Vlasevi/rtuindustrial/README.md

# rtuindustrial
It is a repository with the design files of Industrial RTU for a thesis degree.
