Vlasevi/rtuindustrial/Analog Inputs/Esquematico_capacitor.pdf

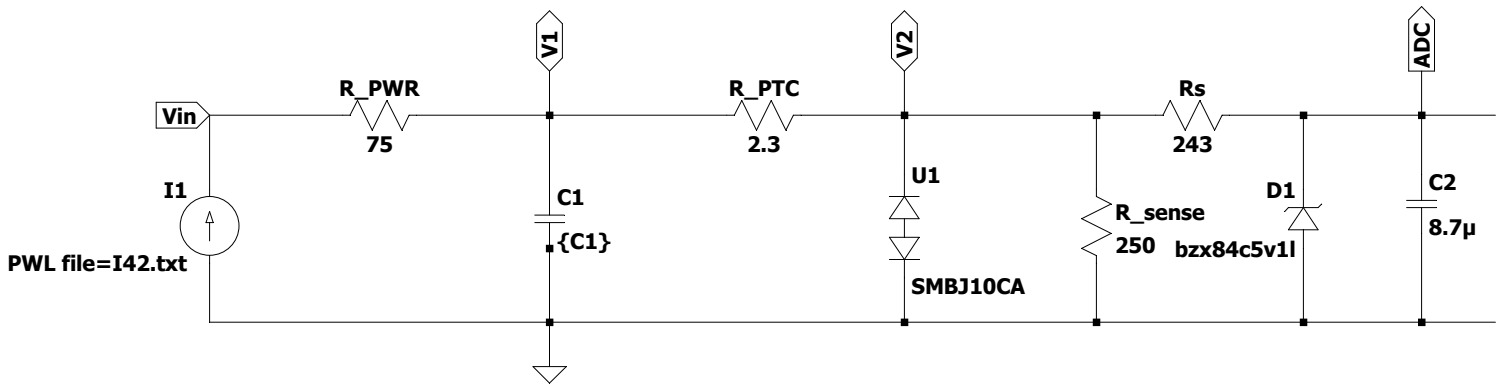
[picture p60: figure]
SMBJ10CA; bzx84c5v1l; R_PWR; R_PTC; R_sense 250; PWL file=I42.txt; ADC; Vin

.lib SPICE_SMBJxxxxCA.lib
.tran 500n
.lib bzx84c5v1l.lib
.step param C1 list 100p 1000p 10n

--- C:\Users\Vladimir Villamizar\Documents\Proyecto de grado\Analog Inputs\tvs_test1.asc ---
