Vlasevi/rtuindustrial/Analog Inputs/Esquemático.pdf

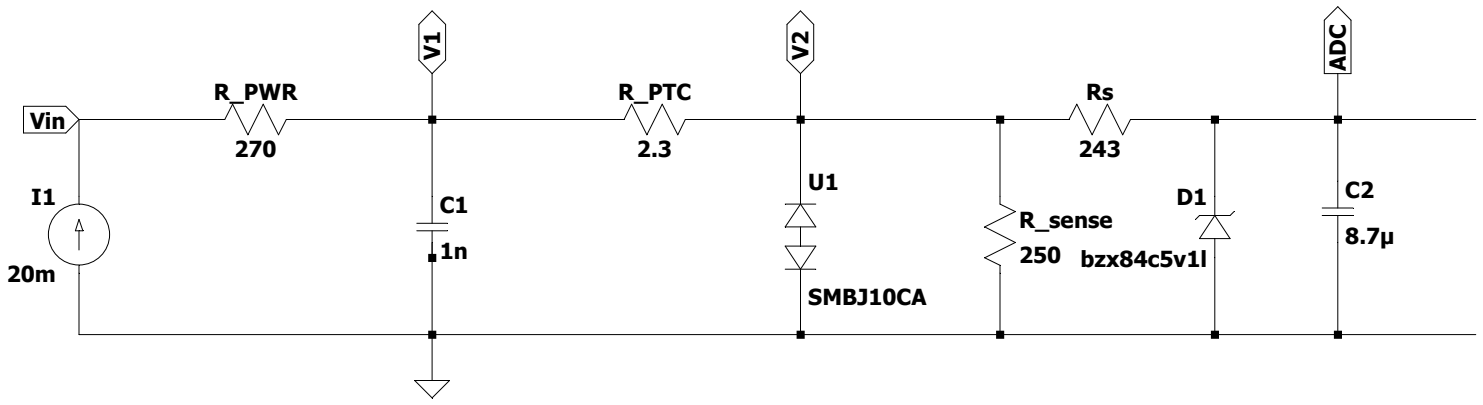
[picture p61: figure]
SMBJ10CA; bzx84c5v1l; R_PWR; R_PTC; R_sense 250; ADC; Vin

.lib SPICE_SMBJxxxxCA.lib
.dc I1 4m 20m 0.01u
.lib bzx84c5v1l.lib

--- C:\Users\Vladimir Villamizar\Documents\Proyecto de grado\Analog Inputs\tvs_test1.asc ---
