Vlasevi/rtuindustrial/Digital Output/Esquematico_figura.pdf

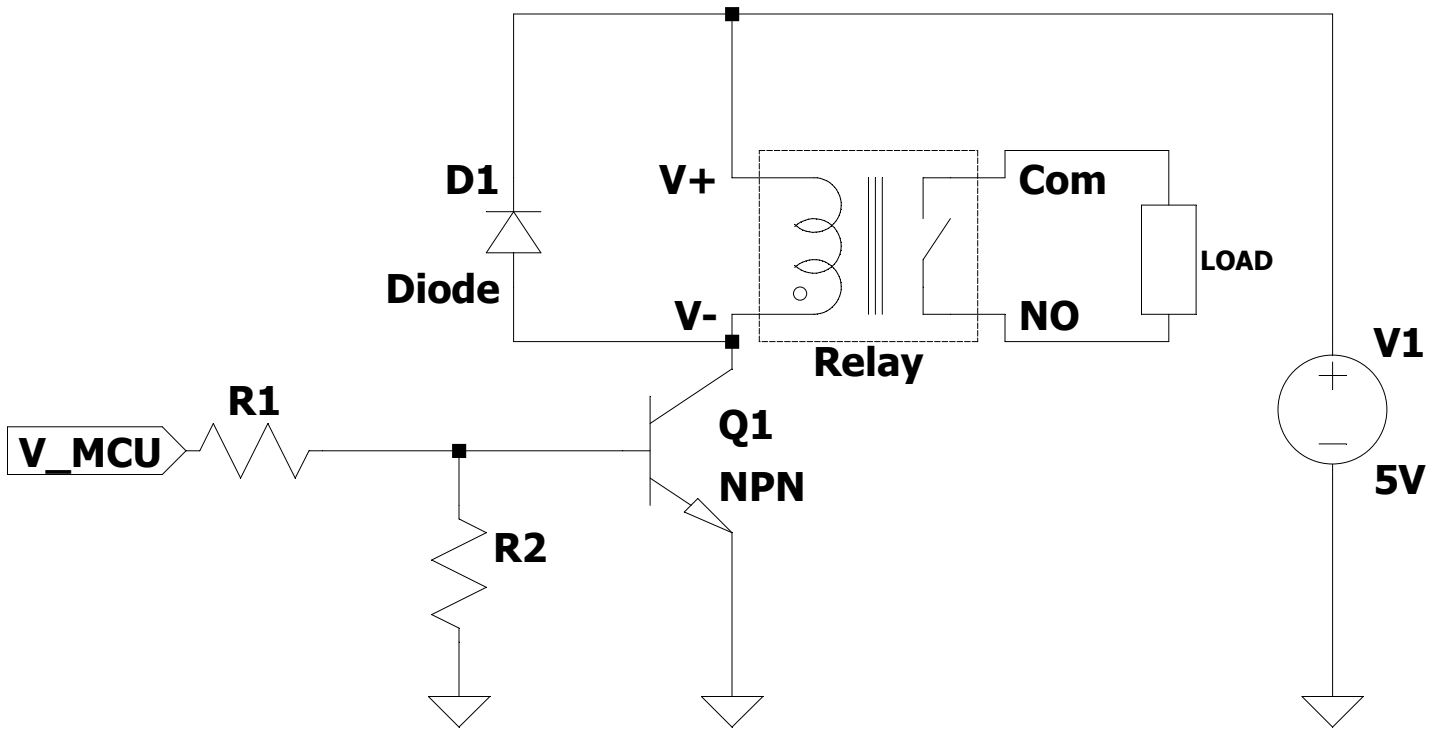
[picture p62: figure]
Q1 NPN; Relay; Com; Diode; V_MCU; LOAD

--- C:\Users\Vladimir Villamizar\Documents\Proyecto de grado\Digital Output\Esuquematico_figura.asc ---
