Vlasevi/rtuindustrial/Digital Output/Esquematico_simulacion.pdf

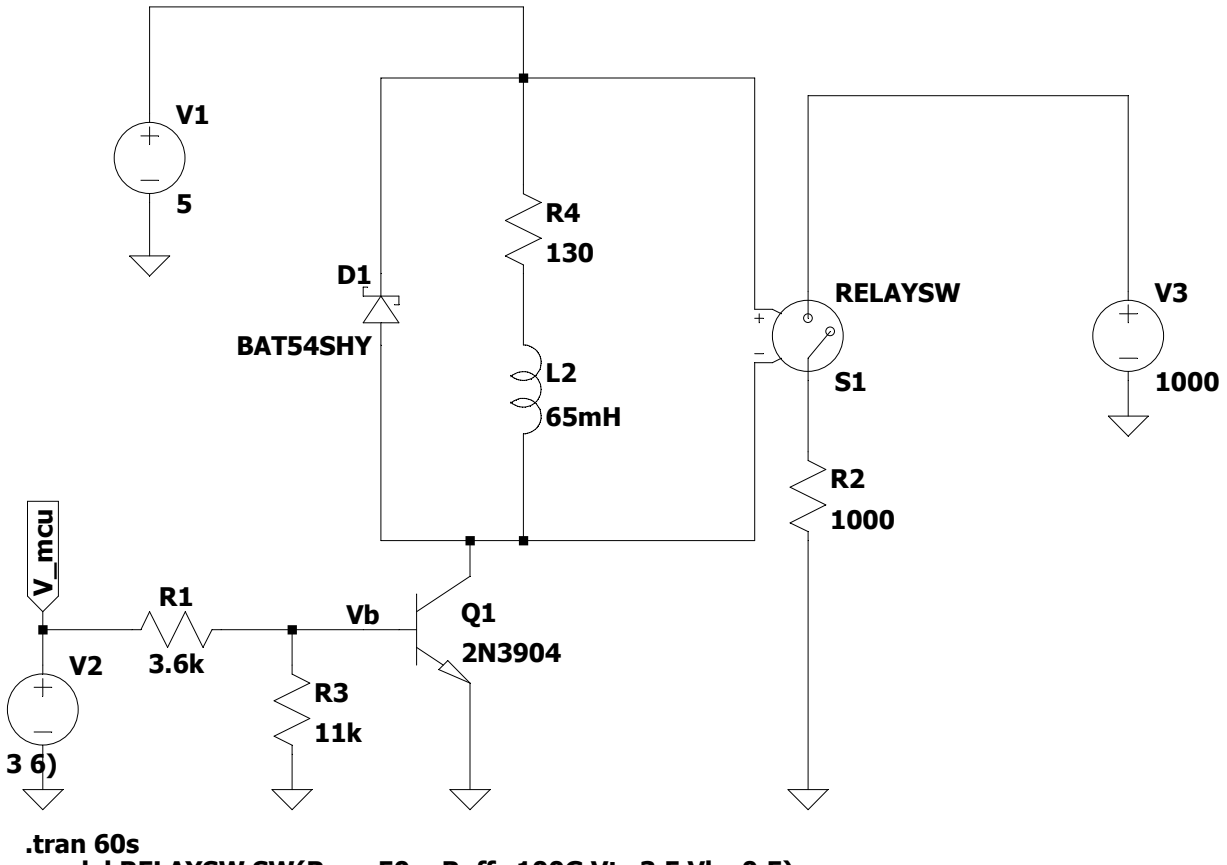
[picture p63: figure]
RELAYSW; BAT54SHY; Vb V_mcu; .tran 60s

PULSE(3.3 0 0 1n 1n 3 6)

.model RELAYSW SW(Ron=50m Roff=100G Vt=3.5 Vh=0.5)

--- C:\Users\Vladimir Villamizar\Documents\Proyecto de grado\Digital Output\DO.asc ---
