Vlasevi/rtuindustrial/Analog Inputs/Calculo rango para ADS114S08/ADS1x4S0x Design Calculator.xlsx

Sheet: Table of Contents
Worksheets | Description
Register Map | Lists the ADS1x4S0x register map fields, descriptions, and the corresponding read/write commands
Digital Filter | Calculates the digital filter's frequency response
Common-Mode Range | Calculates if an applied input signal will satisfy the absolute and differential input range requirements
Code Conversions | Converts ADC raw codes to corresponding voltages
Calibration | Calculations for offset and gain error calibration coefficients
CRC | Calculates the CRC byte
About | Information about this tool
Help | How to use this tool

Sheet: Register Map
 |  |  |  |  |  |  |  |  |  |  |  |  |  | Table of Contents
 | Show Register Map for: |  |  |  | ADS124S08 |  | ← Select a device
 |  |  |  |  |  |  |  | Configure register settings
 | Address (Hex) | Register Name | Read/Write | Default (Hex) | Bit # |  |  |  |  |  |  |  | Value | Read Command | Write Command
 |  |  |  |  | 7 | 6 | 5 | 4 | 3 | 2 | 1 | 0
0 | 0x00 | ID | R | 0xh | ---- |  |  |  |  | DEV_ID[2] | DEV_ID[1] | DEV_ID[0] | 00h | 20h, 00h, 00h | 40h, 00h, 00h
 |  |  |  |  | 0 | 0 | 0 | 0 | 0 | 0 | 0 | 0
 |  |  |  |  | Reserved |  |  |  |  | ADS124S08
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
