Vlasevi/rtuindustrial/Gerber Images PCB/+5.jpg

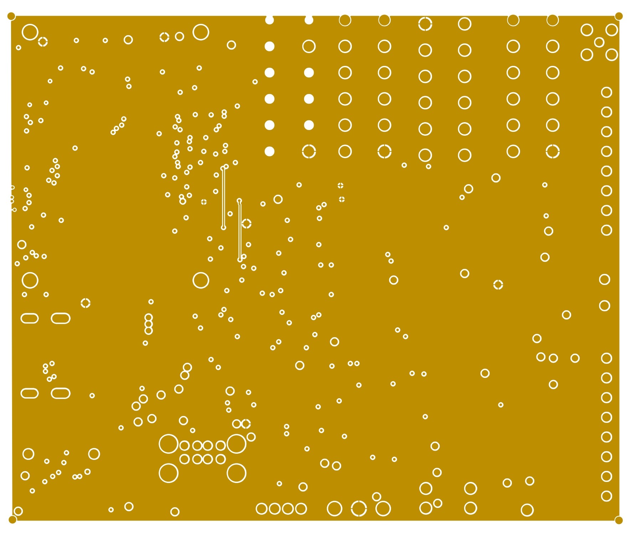
Gerber Images PCB/+5.jpg
