Vlasevi/rtuindustrial/Gerber Images PCB/Borde.jpg

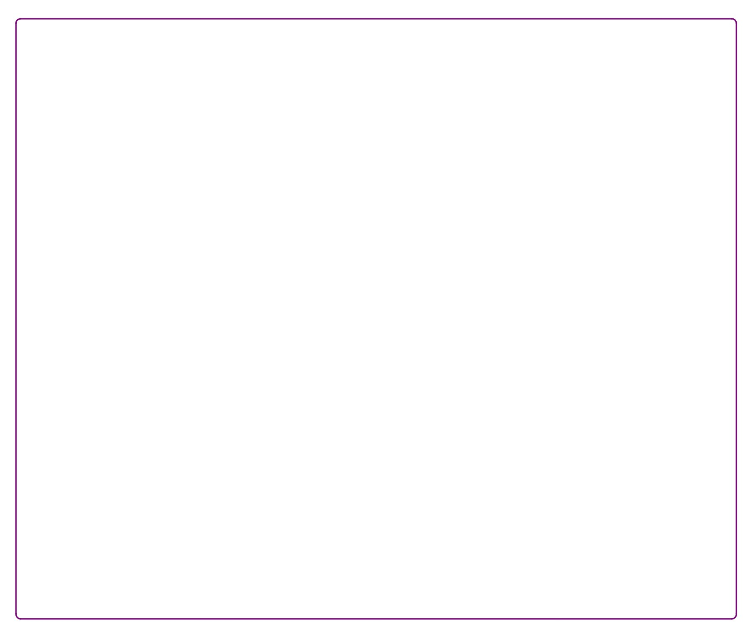
Gerber Images PCB/Borde.jpg
