Vlasevi/rtuindustrial/Gerber Images PCB/Bottom.jpg

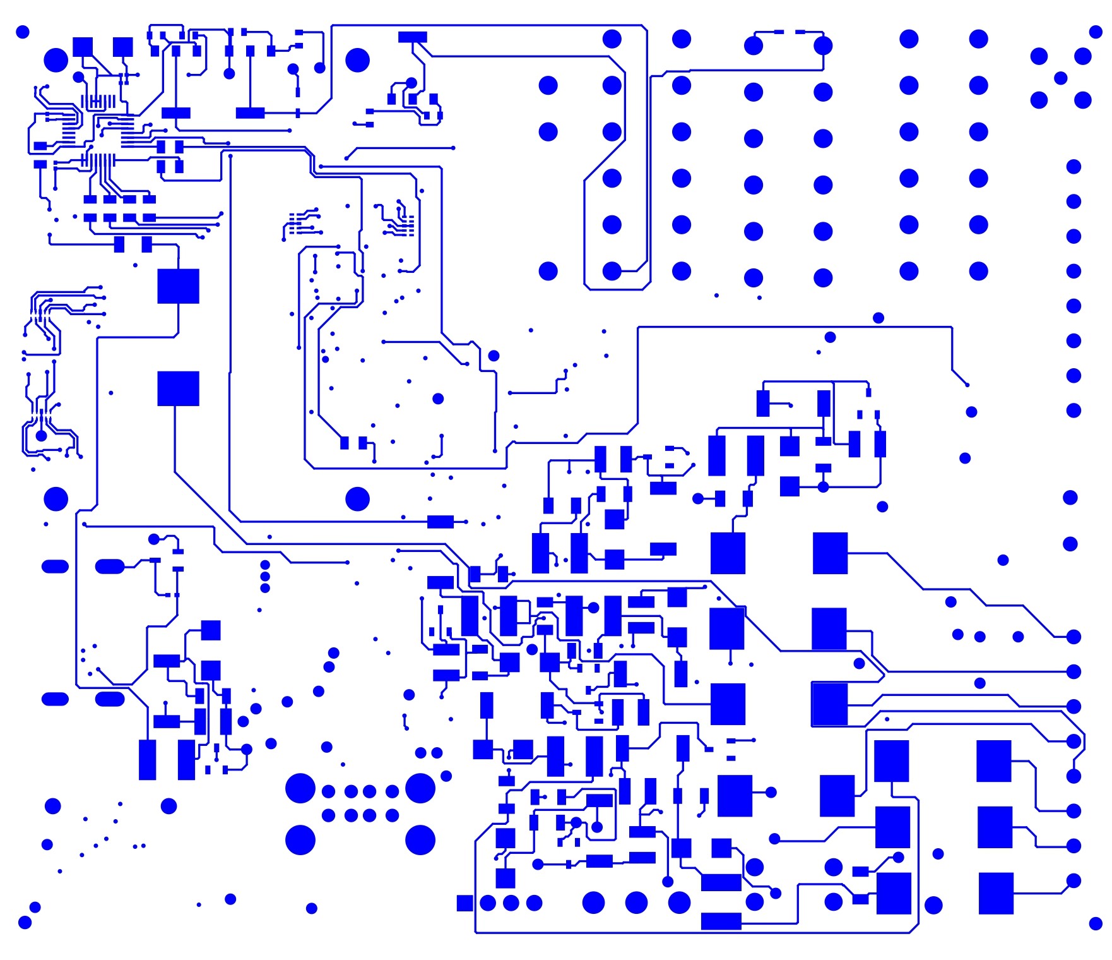
Gerber Images PCB/Bottom.jpg
