Vlasevi/rtuindustrial/Gerber Images PCB/GND.jpg

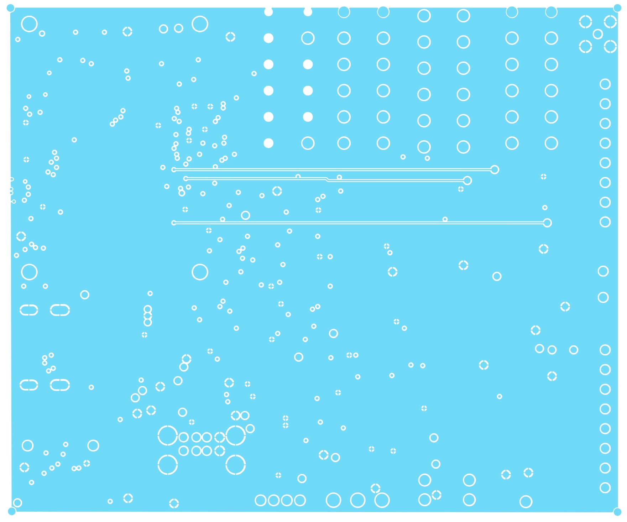
Gerber Images PCB/GND.jpg
