Vlasevi/rtuindustrial/Gerber Images PCB/Signal1.jpg

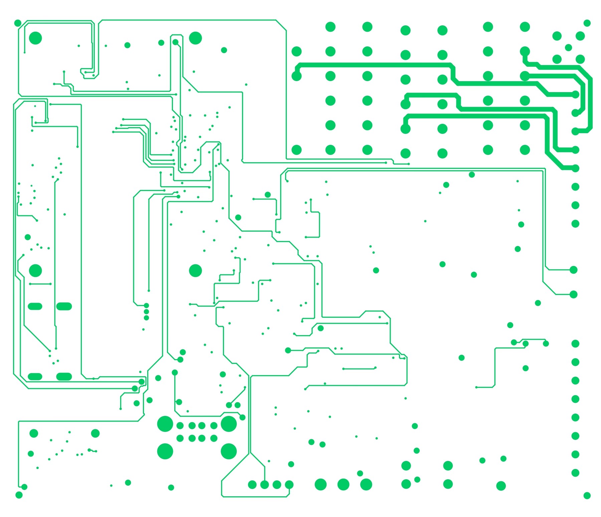
Gerber Images PCB/Signal1.jpg
