Vlasevi/rtuindustrial/Gerber Images PCB/Signal2.jpg

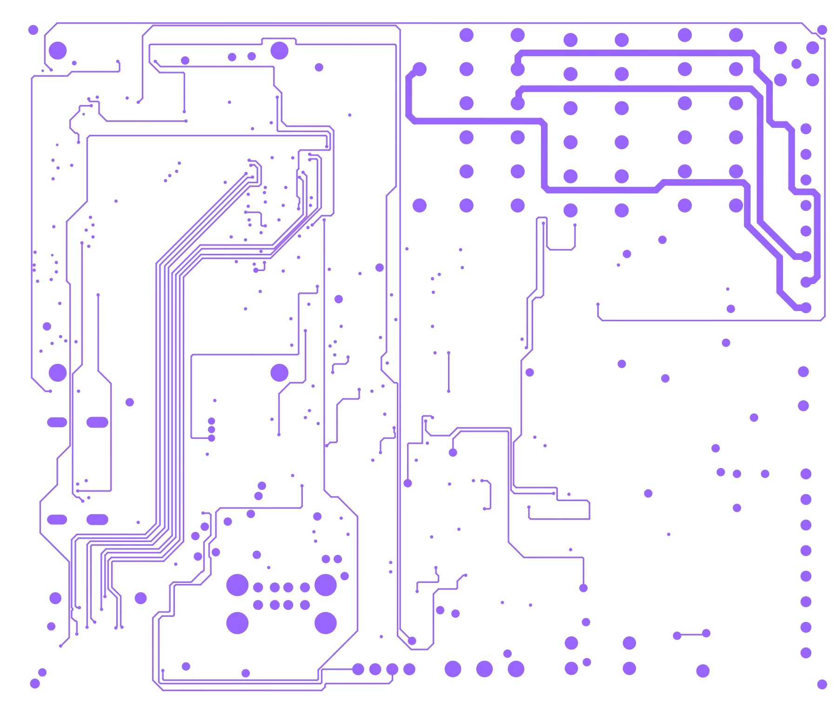
Gerber Images PCB/Signal2.jpg
