Vlasevi/rtuindustrial/Gerber Images PCB/Top.jpg

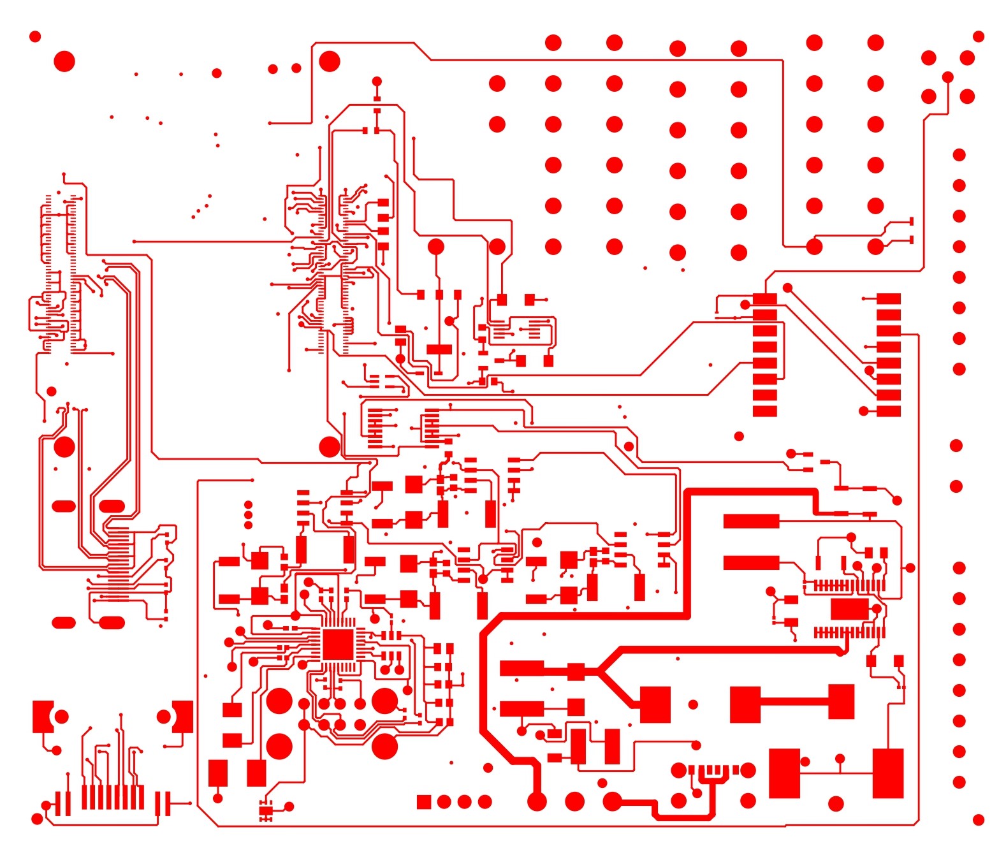
Gerber Images PCB/Top.jpg
