Vlasevi/rtuindustrial/Standards (Orcad and LTspice)/IEC 61000-4-4 (EFT)/IEC 61000-4-4.png

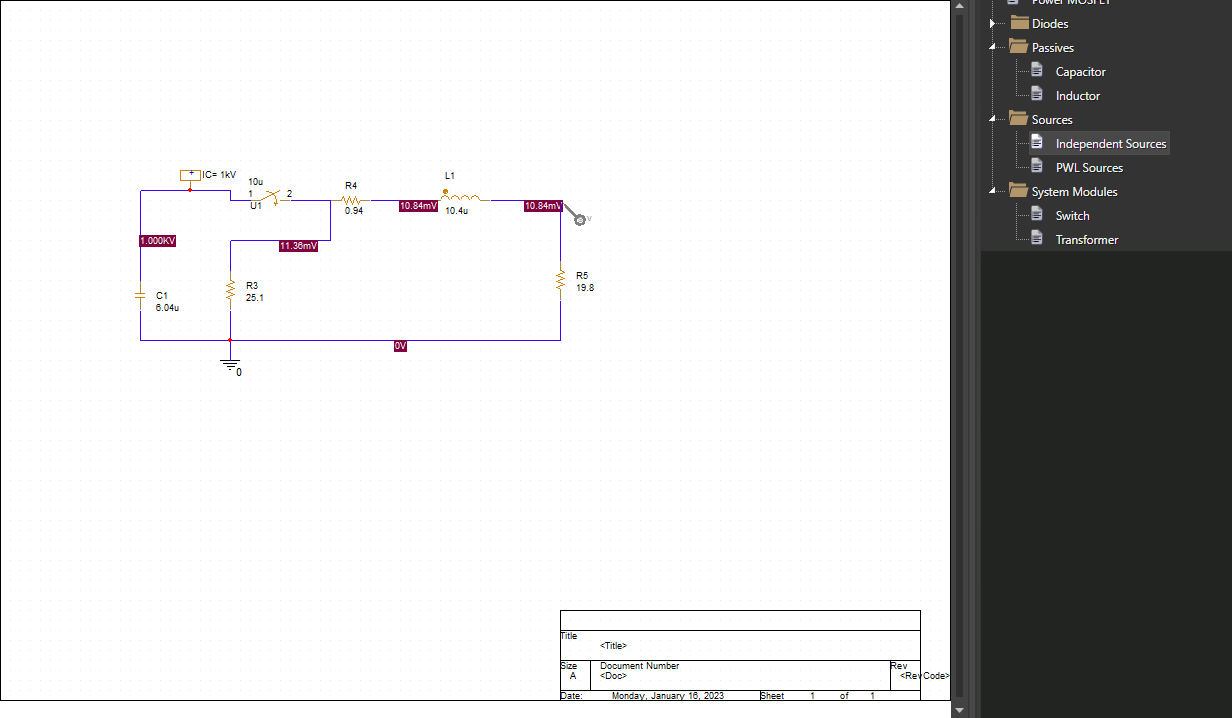
Standards (Orcad and LTspice)/IEC 61000-4-4 (EFT)/IEC 61000-4-4.png
