Vlasevi/rtuindustrial/Standards (Orcad and LTspice)/IEC 61000-4-5 (Surge)/IEC 61000-4-5.png

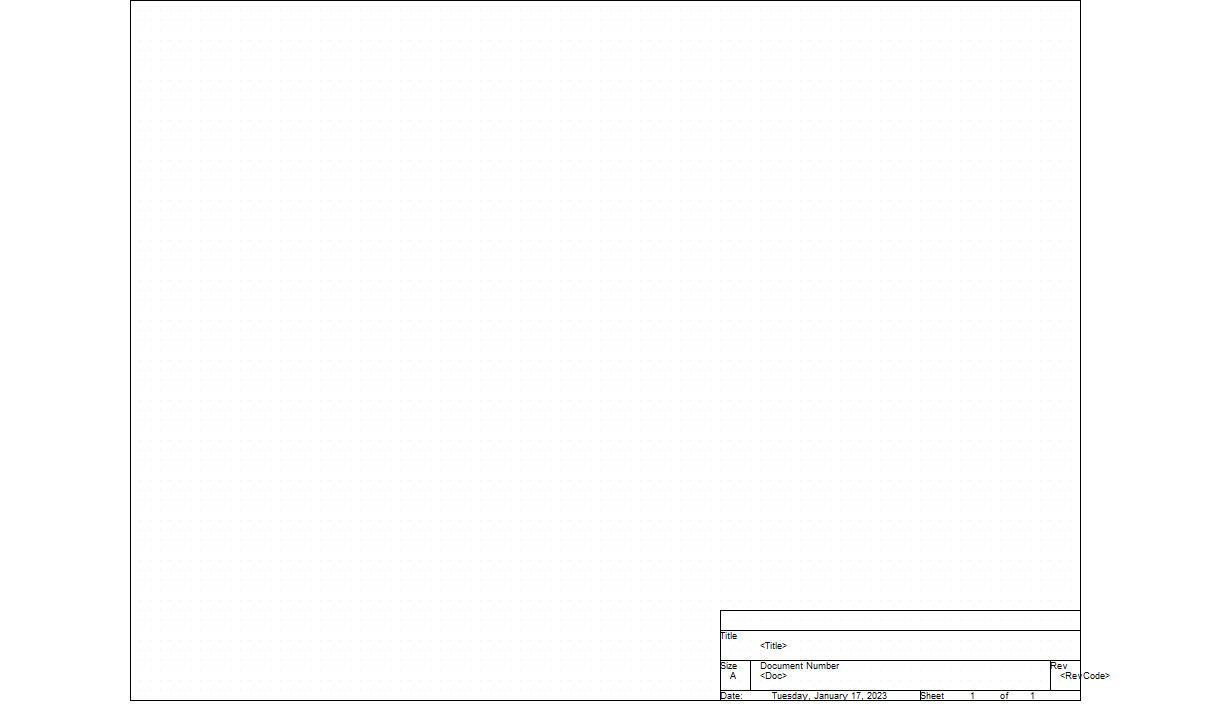
Standards (Orcad and LTspice)/IEC 61000-4-5 (Surge)/IEC 61000-4-5.png
