Vlasevi/rtuindustrial/Bill of Materials.xlsx

LISTA DE MATERIALES RTU INDUSTRIAL
Nombre | Tipo dispositivo | Nombre de parte | Cantidad | Fabricante | Distribuidor | Precio
1PS76SB10,115 | Schottky Diode | D16, D17, D18, D19 | 4.00 | Nexperia | Mouser | $0.27 | $1.08
0402YA270JAT2A | Capacitor | C40, C41 | 2.00 | KYOCERA AVX | Mouser | $0.10 | $0.20
445C33D24M00000 | Crystal or Oscillator | Y1(OSC) | 1.00 | CTS-Frequency Controls | Mouser | $0.52 | $0.52
1002-004-01010 | USB-A (USB TYPE-A), Stacked USB 2.0 | X1 | 1.00 | CNC Tech | DigiKey | $1.39 | $1.39
1101M2S3AV2BE2 | Switch | S3 | 1.00 | C&K | DigiKey | $5.16 | $5.16
2016L030 | Fuse | F1, F2, F3, F4, F5, F6, F7, F8 | 8.00 | LittleFuse | Mouser | $0.65 | $5.20
282834-4 | 4 Position Wire to Board Terminal Block Horizontal | J7 | 1.00 | TE Connectivity | Mouser | $2.37 | $2.37
282837-2 | Connector | J9 | 1.00 | TE Connectivity | Mouser | $0.68 | $0.68
352212KFT | Resistor | R67 | 1.00 | TE Connectivity | Mouser | $1.00 | $1.00
1727078 | Connector | J6, J8 | 2.00 | Phoenix Contact | Mouser | $5.60 | $11.20
6339191-5 | Conn RJ-45 F 8 POS | J1 | 1.00 | TE Connectivity | Mouser | $6.06 | $6.06
685119134923 | HDMI - Receptacle Connector 19 Position | J4 | 1.00 | Wurth Elektronik | Mouser | $2.52 | $2.52
885012207014 | Capacitor | C17 | 1.00 | Wurth Elektronik | Mouser | $0.10 | $0.10
ADS1148IPW | Integrated Circuit | IC1 | 1.00 | Texas Instruments | Mouser | $11.96 | $11.96
AP22653W6-7 | Integrated Circuit | IC14 | 1.00 | Diodes Incorporated | Mouser | $0.49 | $0.49
BZX84C5V1LT1G | Zener Diode | Z1, Z2, Z3, Z4, Z5,Z6,Z7,Z8 | 8.00 | Discret Semiconductor | Mouser | $0.16 | $1.28
C0201X5R6R3-105KNP | Capacitor | C19, C100 | 2.00 | Venkel | Mouser | $0.01 | $0.02
C0201X5R100-104KNP | Capacitor | C18, C29, C30 | 3.00 | Venkel | Mouser | $0.00208 | $0.01
C1206C102KAREC7210 | Capacitor | C1, C3, C5, C7, C9,C11,C13,C15 | 8.00 | KEMET | Mouser | $0.24 | $1.92
C1210X825K3RAC7800 | Capacitor | C2, C4, C6, C8, C10,C12,C14,C16 | 8.00 | KEMET | Mouser | $0.87 | $6.96
C3216X5R1A476M160AB | Capacitor | C34, C35, C36 | 3.00 | TDK | Mouser | $0.86 | $2.58
CC0603JPX7R9BB104 | Capacitor | C23, C24, C25, C26 | 4.00 | YAGEO | Mouser | $0.10 | $0.40
CDSOT23-SM712 | Diode | D21 | 1.00 | Bourns | Mouser | $1.53 | $1.53
CGA0603MLA-31900E | Varistor | RV1, RV2, RV3, RV4 | 4.00 | Bourns | Mouser | $0.40 | $1.60
CM21X5R107M06AT | Capacitor | C42 | 1.00 | KYOCERA AVX | Mouser | $1.27 | $1.27
CRCW20102K40JNEF | Resistor | RTHR1, RTHR2, RTHR3, RTHR4 | 4.00 | Vishay | DigiKey | $0.29 | $1.16
CRCW020115K0FKED | Resistor | R69 | 1.00 | Vishay | Mouser | $0.25 | $0.25
CRCW080547R0JNEAIF | Resistor | R33, R34, R35, R36,R37,R38,R39,R48 | 8.00 | Vishay | DigiKey | $0.55 | $4.40
CRCW0603010RJNEAHP | Resistor | R63, R64 | 2.00 | Vishay | DigiKey | $0.10 | $0.20
CRM1206QFX-1003ELF | Resistor | R59 | 1.00 | Bourns | Mouser | $1.22 | $1.22
CRT1206-PW-2500ELF | Resistor | R2, R6, R10, R14,R19,R23,R26,RR30 | 8.00 | Bourns | Mouser | $0.77 | $6.16
ERA-3ARB113V | Resistor | R50, R52, R54, R56 | 4.00 | Panasonic | Mouser | $0.68 | $2.72
ERA-3VEB3601V | Resistor | R49, R51, R53, R55 | 4.00 | Panasonic | Mouser | $0.65 | $2.60
ERA-8VRB1002V | Resistor | R60, R65, R66 | 3.00 | Panasonic | Mouser | $1.32 | $3.96
ERJ-1TNF2430U | Resistor | R4, R8, R12, R16,R20,R24,R28,R32 | 8.00 | Panasonic | DigiKey | $1.65 | $13.20
ESD224DQAR | Integrated Circuit | IC15c, IC16 | 2.00 | Texas Instruments | Mouser | $1.52 | $3.04
ESD321DPYR | TVS Diode (Bi-directional) | D29, D30, D31, D32 | 4.00 | Texas Instruments | Mouser | $0.37 | $1.48
ISO1211DR | Integrated Circuit | IC2, IC3, IC4, IC5 | 4.00 | Texas Instruments | Mouser | $1.07 | $4.28
KAM15CT70J106KT | Capacitor | C43, C44, C45, C46 | 4.00 | KYOCERA AVX | Mouser | $0.40 | $1.60
KRM55WR71J226MH01K | Capacitor | C33 | 1.00 | Murata | Mouser | $3.93 | $3.93
LTC3649EFE#PBF | Integrated Circuit | IC8 | 1.00 | Analog Devices | Mouser | $15.62 | $15.62
MAASL063SB7103KFCA01 | Capacitor | C37, C38 | 2.00 | 4D5156 TAIYO YUDEN | Mouser | $0.12 | $0.24
MCT0603HZ0000ZP500 | Resistor | RGND | 1.00 | Vishay | Mouser | $0.64 | $0.64
PJ-036AH-SMT-TR | DC Power Jack Connector | J5 | 1.00 | 4D5156 CUI Devices | Mouser | $1.40 | $1.40
PWR5322W1R00JE | Resistor | R57 | 1.00 | Bourns | Mouser | $1.16 | $1.16
PWR5322W5R00JE | Resistor | R1, R5 | 2.00 | Bourns | Mouser | $1.12 | $2.24
PWR5322W75R0JE | Resistor | R9, R13, R17, R21, R25, R29 | 6.00 | Bourns | Mouser | $1.42 | $8.52
PZT3904 | Transistor BJT NPN | Q1, Q2, Q3, Q4 | 4.00 | 333333 Micro Commercial Components | Mouser | $0.41 | $1.64
RC0402FR-0736KL | Resistor | R68, R70, R71, R72 | 4.00 | YAGEO | Mouser | $0.10 | $0.40
REF3033AIDBZRG4 | Integrated Circuit | IC19 | 1.00 | Texas Instruments | Mouser | $0.92 | $0.92
RFM95W-915S2 | RFM95(W) - Low Power | IC12 | 1.00 | RF Solutions | Mouser | $21.00 | $21.00
RMCF2512FT13R3 | Resistor | Rsense11, Rsense22,Rsense33,Rsense44 | 4.00 | Stackpole Electronics | DigiKey | $0.27 | $1.08
RN73C2A200KBTDF | Resistor | R58 | 1.00 | 4D5156 TE Connectivity | Mouser | $1.02 | $1.02
RT9742SNGV | Integrated Circuit | IC18 | 1.00 | 4D5156 Richtek USA | Mouser | $0.55 | $0.55
S2EB-5V | Relay or Contactor | K1, K2, K3, K4 | 4.00 | Panasonic | Mouser | $15.60 | $62.40
SC0320 | COMPUTE 4 1GB RAM 16GB EMMC | MCU | 1.00 | Raspberry Pi | MD | $44.00 | $44.00
SDR10EZPJ471 | Resistor | R61, R62 | 2.00 | ROHM | Mouser | $0.22 | $0.44
LPRS_SMA_CONNECTOR | Straight SMA Connector | J3 | 1.00 | LPRS | Mouser | $1.40 | $1.40
SMBJ10CA | TVS Diode (Bi-directional) | D1, D2, D3, D4,D5,D6,D7,D8 | 8.00 | LittleFuse | Mouser | $0.42 | $3.36
SMBJ30CA | TVS Diode (Bi-directional) | D10, D11,D12,D13,D14 | 5.00 | LittleFuse | Mouser | $0.37 | $1.85
SMBJ36CA | TVS Diode (Bi-directional) | D20 | 1.00 | LittleFuse | Mouser | $0.37 | $0.37
SN74LV165ADBR | Integrated Circuit | IC6 | 1.00 | Texas Instruments | Mouser | $0.92 | $0.92
SN74LVC1GU04DCKR | Integrated Circuit | IC7 | 1.00 | Texas Instruments | Mouser | $0.41 | $0.41
THVD1452DGS | Integrated Circuit | IC11 | 1.00 | Texas Instruments | Mouser | $3.79 | $3.79
TMS-103-54-G-S | Connector | JR | 1.00 | Samtec Inc | Mouser | $1.02 | $1.02
TPD1E01B04DPYRQ1 | TVS Diode (Bi-directional) | D22 | 1.00 | Texas Instruments | Mouser | $0.49 | $0.49
TPD1E05U06DPYT | Integrated Circuit | D23, D24, D25,D26,D27,D28 | 6.00 | Texas Instruments | Mouser | $0.87 | $5.22
TPD4EUSB30DQAR | Integrated Circuit | IC9, IC10 | 2.00 | Texas Instruments | Mouser | $0.80 | $1.60
TVS0500DRVR | Integrated Circuit | IC17 | 1.00 | Texas Instruments | Mouser | $0.65 | $0.65
USB2514B-I_M2 | Integrated Circuit | IC13 | 1.00 | Microchip Tech | Mouser | $3.74 | $3.74
USB4125-GF-A-0190 | Connector | JP | 1.00 | GCT | Mouser | $0.67 | $0.67
XAL8080-103MEB | Inductor | L1 | 1.00 | 4D5156 Coilcraft Power Inductors | Mouser | $6.11 | $6.11
 |  |  |  |  | Total | $312.57
