Vlasevi/rtuindustrial/Power/Esquematico_simulacion.pdf

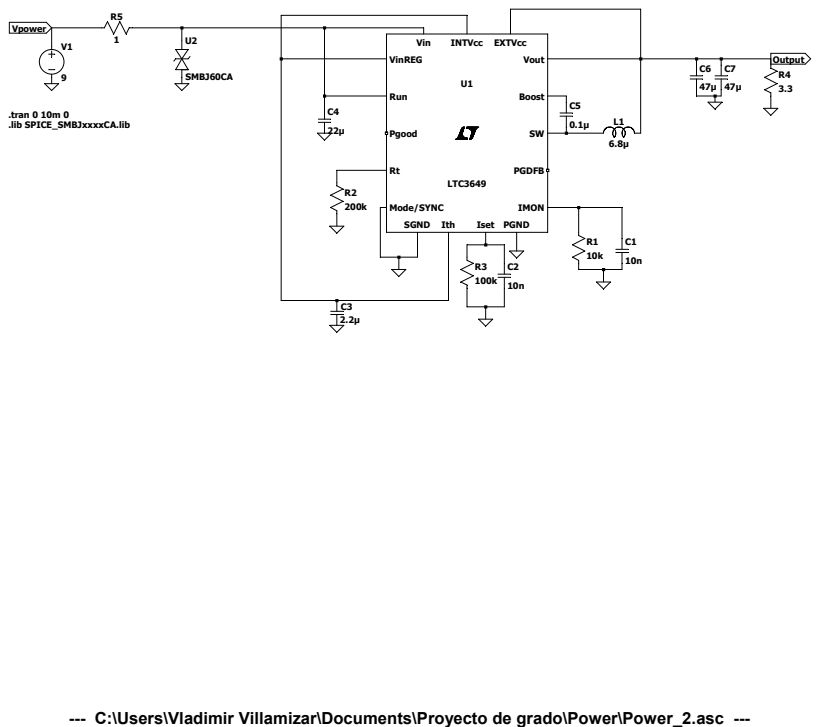
[picture p73: page 1]

--- C:\Users\Vladimir Villamizar\Documents\Proyecto de grado\Power\Power_2.asc ---
