Vlasevi/rtuindustrial/Schematics/RTU_Schematics.pdf

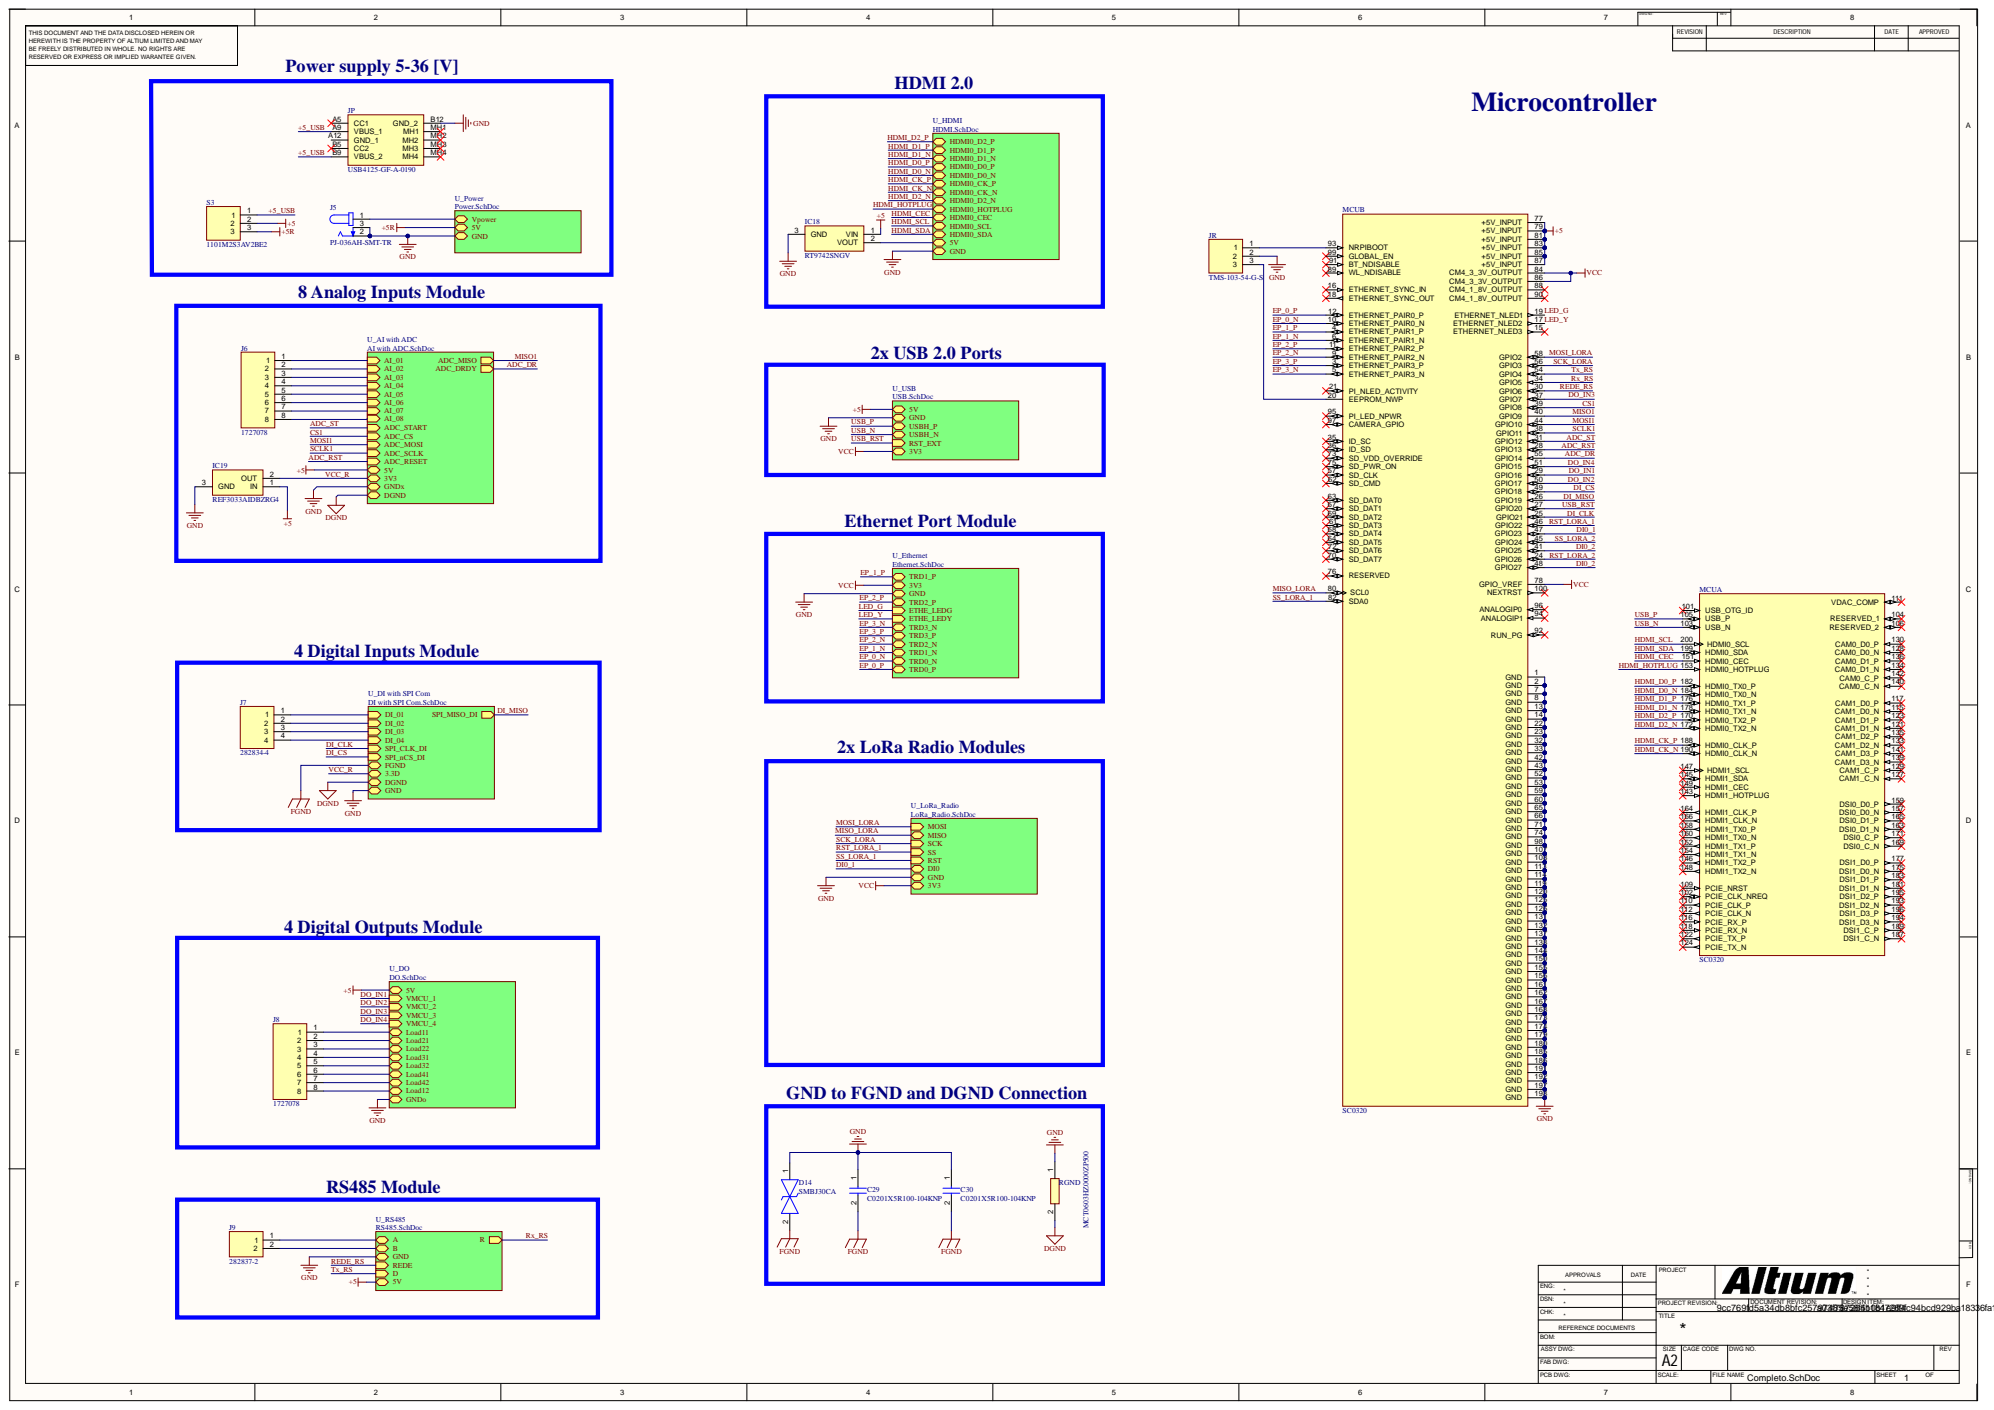
[picture p74: page 1]

T H I S D O C U M E N T A N D T H E D ATA D I S CLO S E D H E R E I N O R H E R EWI T H I S T H E P R O P E R T Y O F A LT I U M LI M I T E D A N D M AY B E F R E E LY D I S T R I B U T E D I N WH OLE . N O R I G H T S A R E R E S E R V E D O R E X P R E S S O R I M PLI E D WA R A N T E E G I V E N . | | REVISION | DESCRIPTION | DATE | APPROVED

GND to FGND and DGND Connection

A P P R O VALS | D AT E | P R OJE C T | ****

E N G :
** D S N : | | P R OJE C T R E V I S I O N : 9cc7 6 9 | D O C U M E N T R E V I S I O N : f d 5 a 3 4 d b 8 b fc2 5 7a90734f8758e75286f45 | D E S I G N I T E M : b1 10 8b41 7e296ff94fc9 4 bcd 9 2 9 b | a
C H K : * | | T I TLE SIZE *

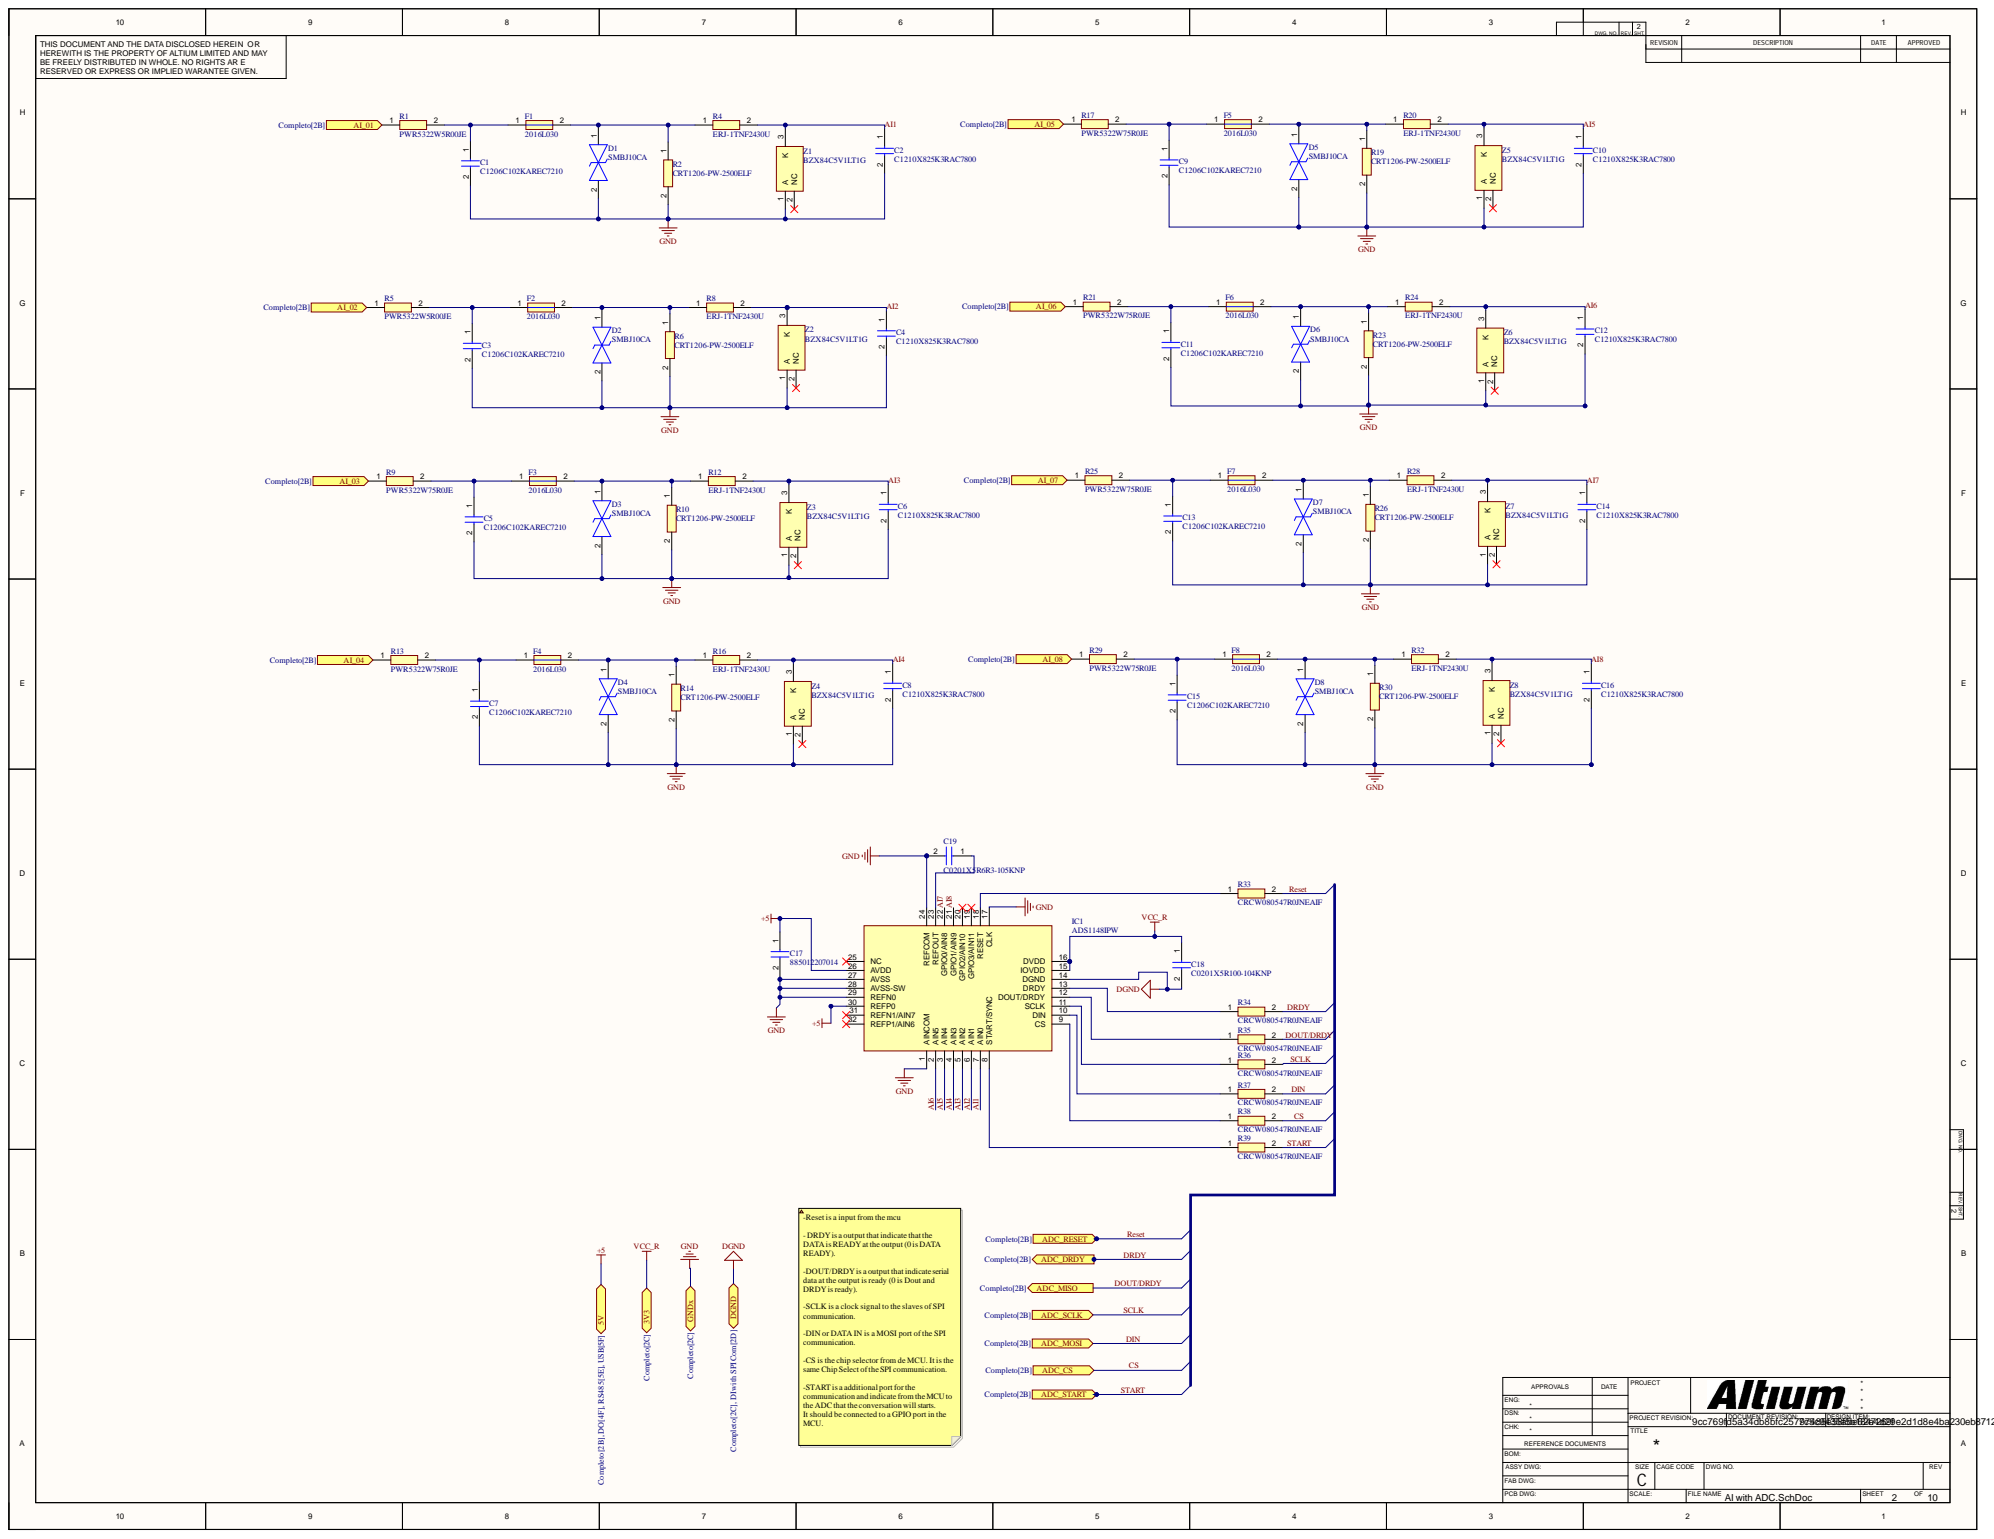
[picture p75: page 2]

DWG. NO. | REV. | SHT. 2

THIS DOCUMENT AND THE DATA DISCLOSED HEREIN OR HEREWITH IS THE PROPERTY OF ALTIUM LIMITED AND MAY BE FREELY DISTRIBUTED IN WHOLE. NO RIGHTS ARE RESERVED OR EXPRESS OR IMPLIED WARANTEE GIVEN. | 1 2 F1 1 2 R4 1 2 F5 1 2 R20 | REVISION | DESCRIPTION | DATE | APPROVED

DGND

REV. SHT. DWG. NO.

-Reset is a input from the mcu

- DRDYis a output that indicate that the
DATAisREADYat the output(0 is DATA
READY).

-DOUT/DRDYis a output that indicate serial
data at the output is ready (0 is Dout and
DRDYisready).

DGND Completo[2C], DIwith SPICom[2D]

-SCLK is a clock signal to the slaves of SPI
communication.

-DIN or DATA IN is a MOSI port of the SPI

-CS is the chip selector from de MCU. It is the
same Chip Select of the SPI communication.

DATE | PROJECT | * * APPROVALS * *

-START is a additional portfor the
communication and indicate from the MCU to
the ADC that the conversation willstarts.
Itshould be connected to a GPIO port in the
MCU.

ENG: *
CHK: * | | TITLE *

DSN: * | | PROJECT REVISION: | DOCUMENT REVISION: | DESIGN ITEM:

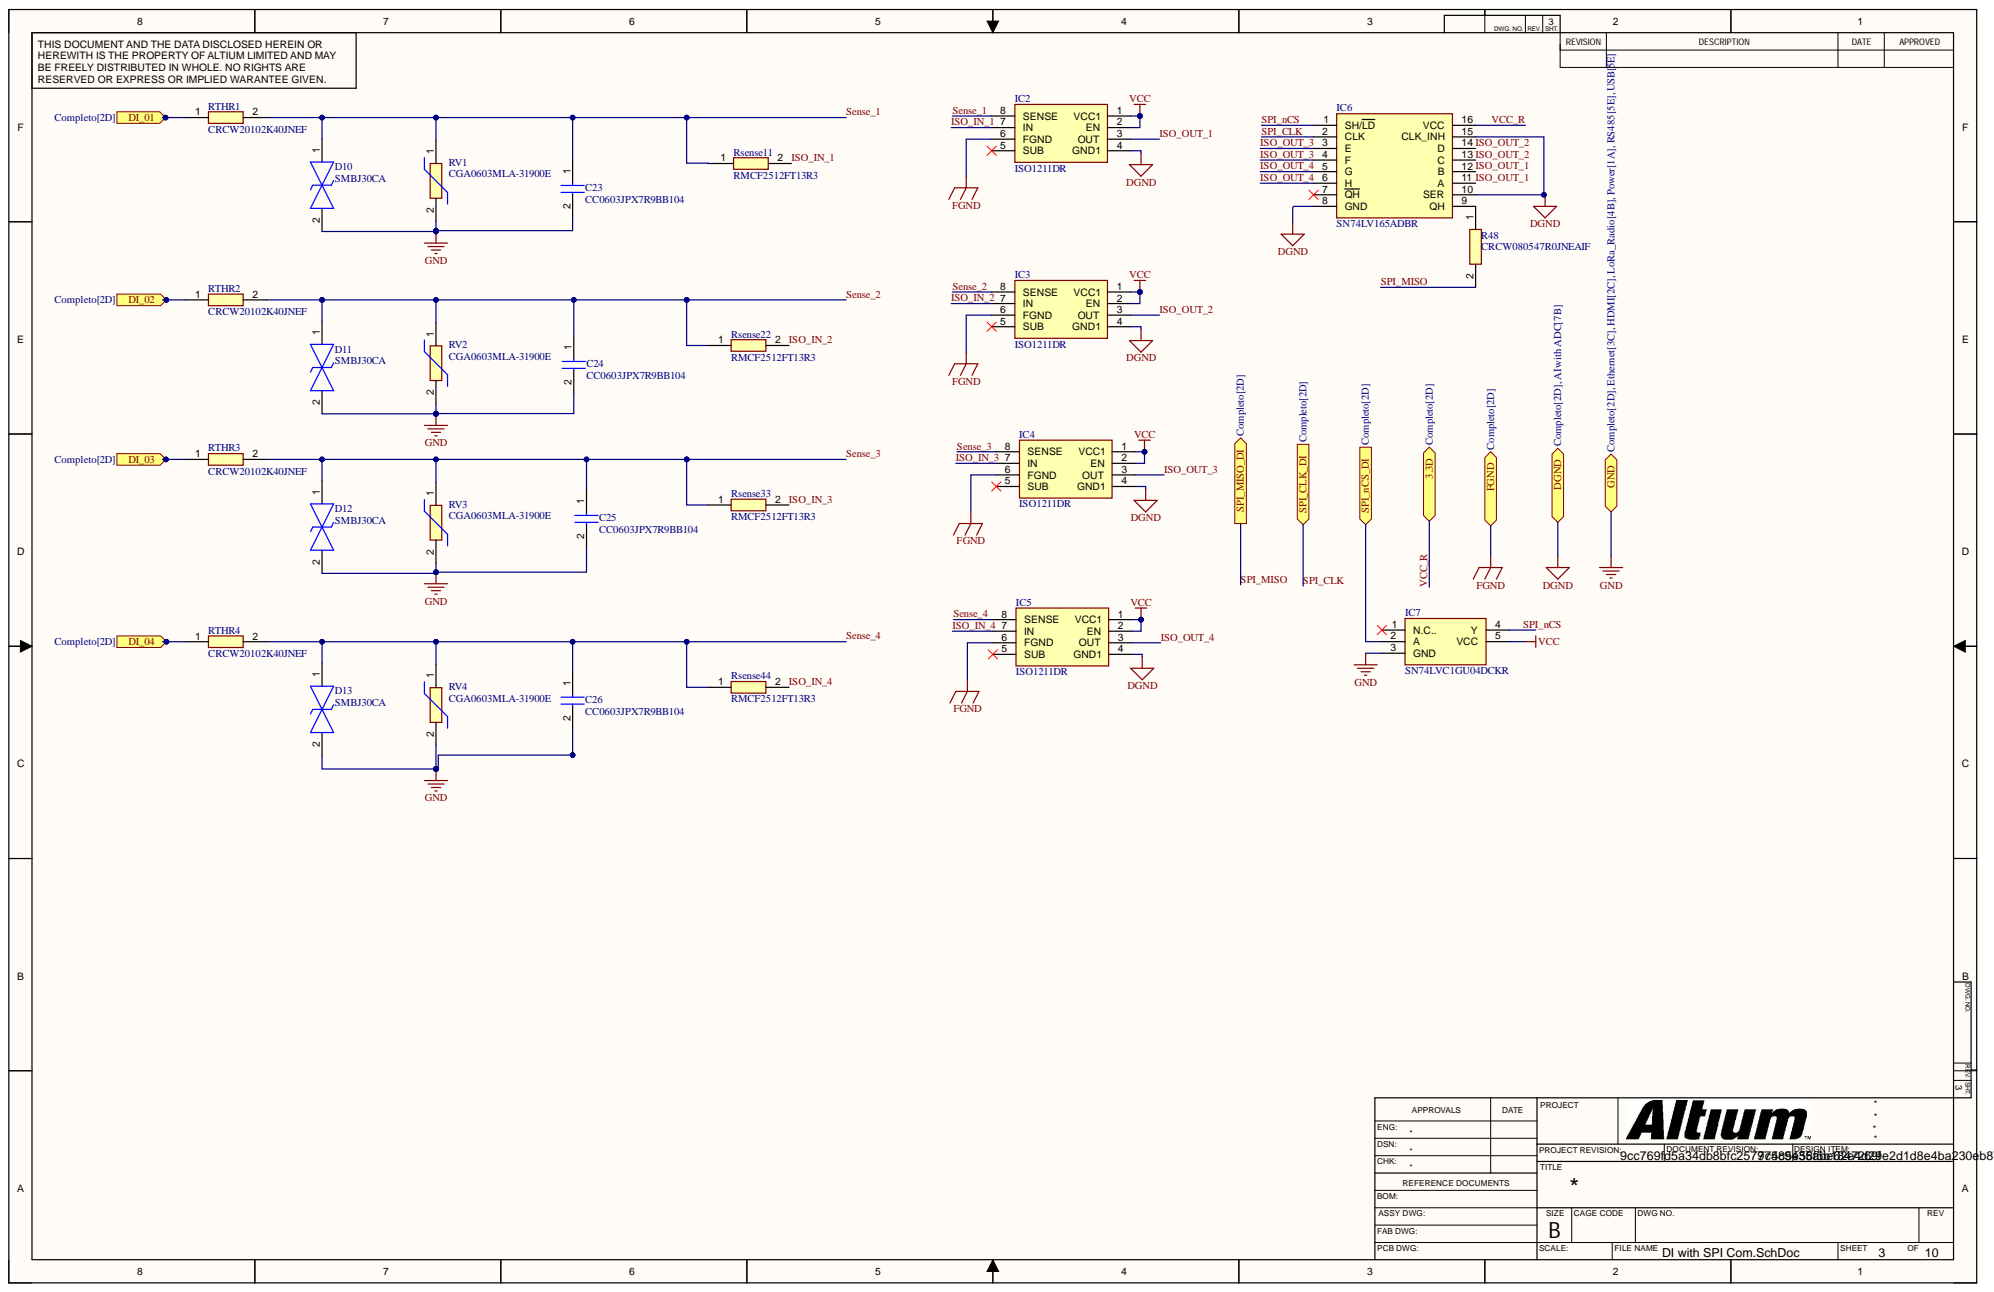
[picture p76: page 3]

DWG. NO | . REV | 3 . SHT | .

TH IS D O C UMEN T AN D THE D ATA D ISCLOSED HEREI N O R HEREWITH IS THE PR OPERTY OF ALTI UM LIMITED AN D MAY BE FREEL Y D ISTR IBUTED I N WH OLE. N O R I G HTS AR E RESERVED O R EXPRESS O R IMPLIED WARANTEE G IVEN . | VCC | RE VISION | DE SCRIPTION | DATE | APPROVE D

GND Completo[2D], Ethernet[3C], HDMI[2C], LoRa_Radio[4B], Power[1A], RS485[5E], USB[5E]

DGND Completo[2D], AIwith ADC[7B]

REV. SHT. DWG. NO.

DATE | PROJEC T | **** APPROVALS

ENG: DSN:

PROJEC T REVISION : 9c c769fd5a34db8bfc25797485e58f5b184 7c5c9435abe62e4d29e2d1d8e4ba230eb 7269f | DOC U MEN T REVISION : | DESIGN I TEM :

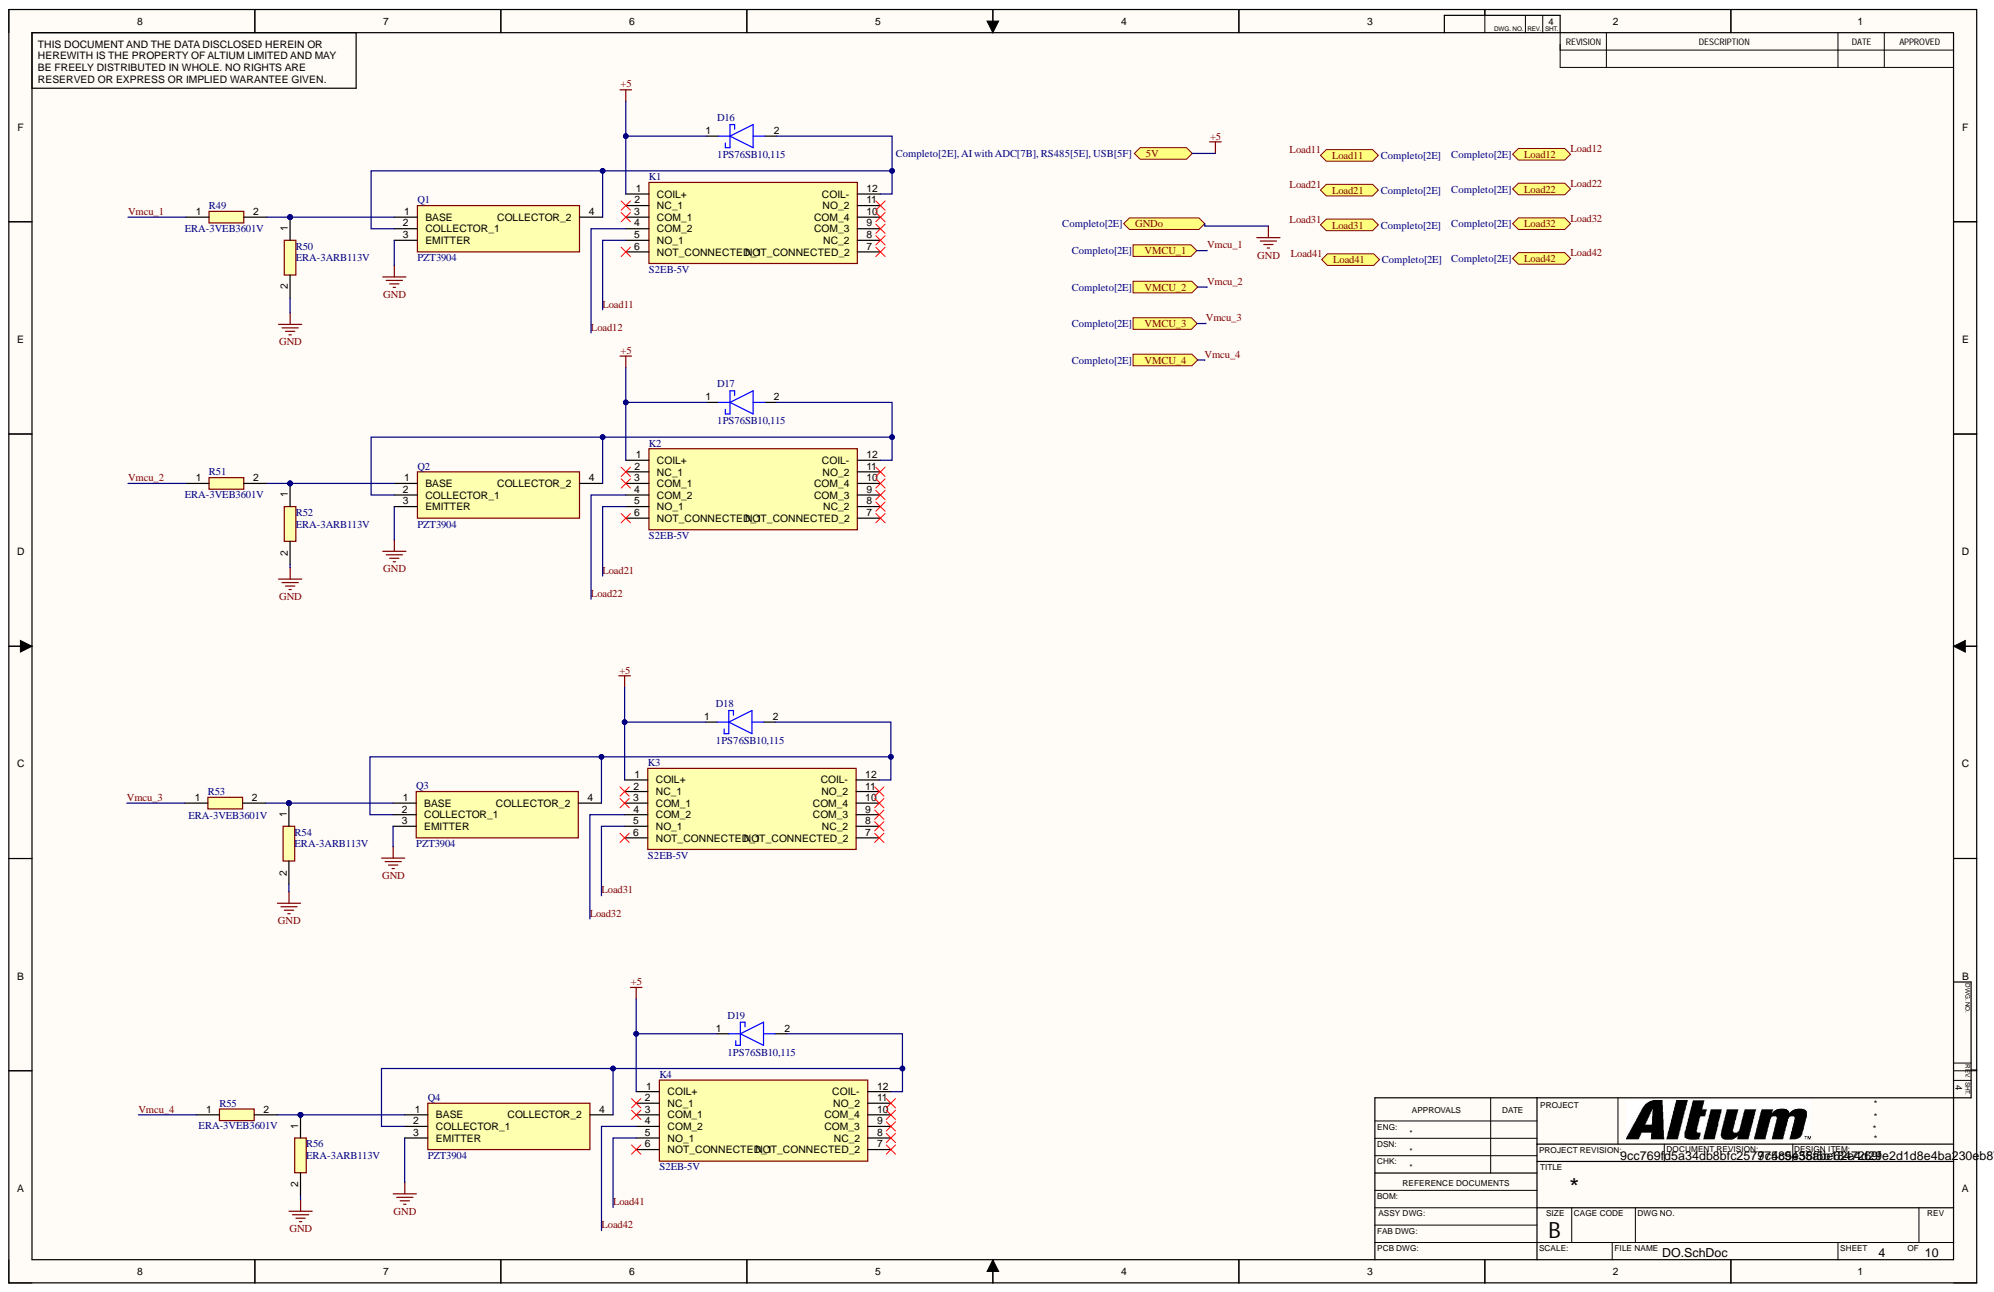
[picture p77: page 4]

8 | 7 | 6 | 5 | 4 | 3 | DWG. NO. | REV. | 4 SHT. | 2 | 1

THIS DOCUMENT AND THE DATA DISCLOSED HEREIN OR HEREWITH IS THE PROPERTY OF ALTIUM LIMITED AND MAY BE FREELY DISTRIBUTED IN WHOLE. NO RIGHTS ARE RESERVED OR EXPRESS OR IMPLIED WARANTEE GIVEN. | +5 | REVISION | DESCRIPTION | DATE | APPROVED

REV. SHT. DWG. NO.

PROJECT REVISION: | DOCUMENT REVISION: | DESIGN ITEM:

CHK: *

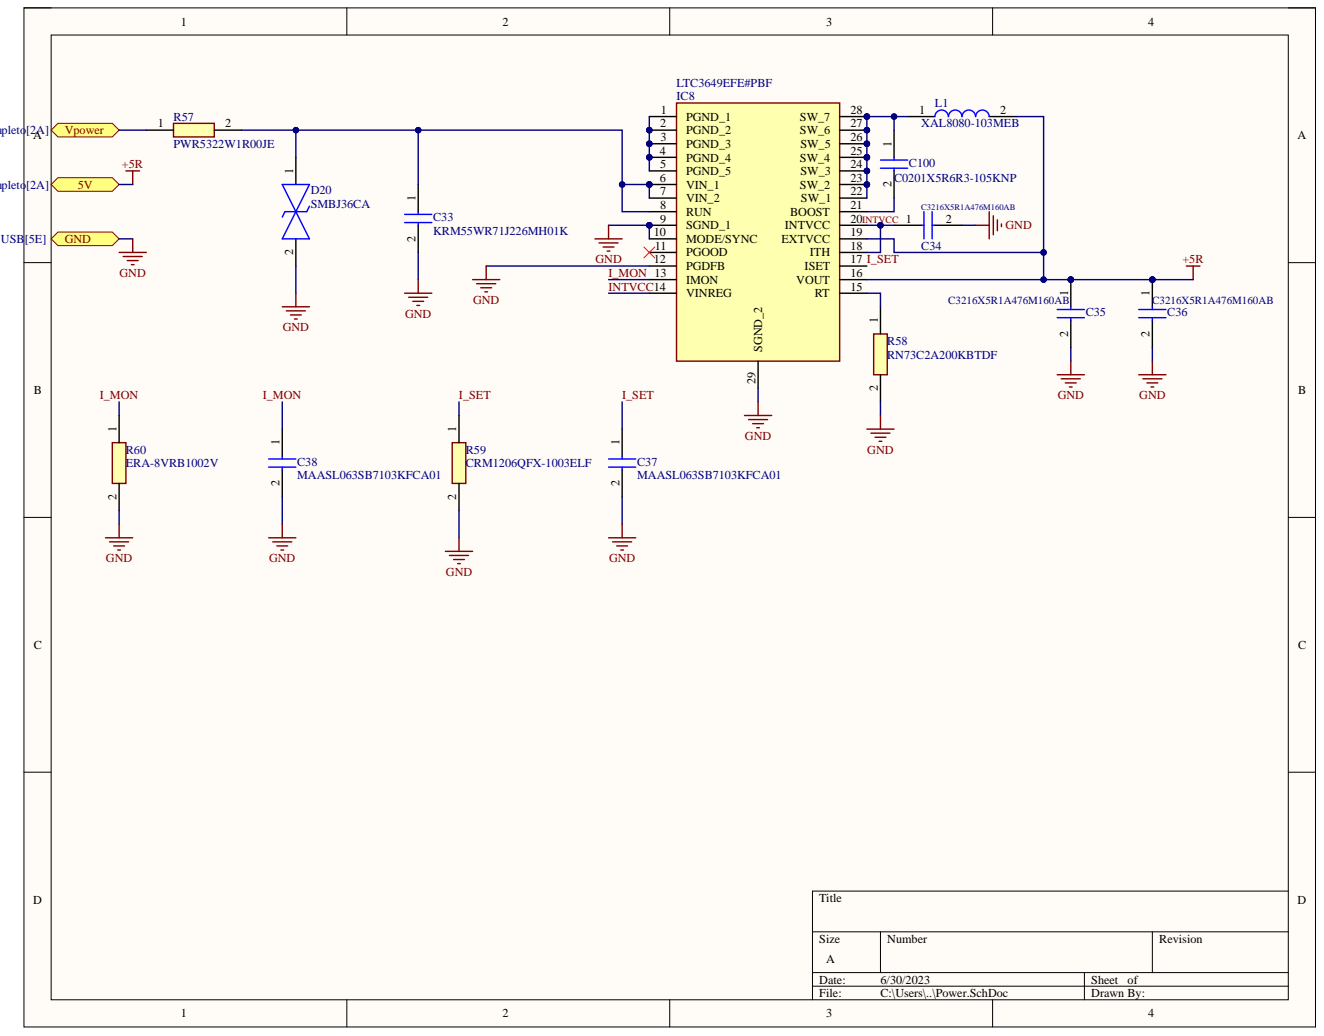
[picture p78: page 5]

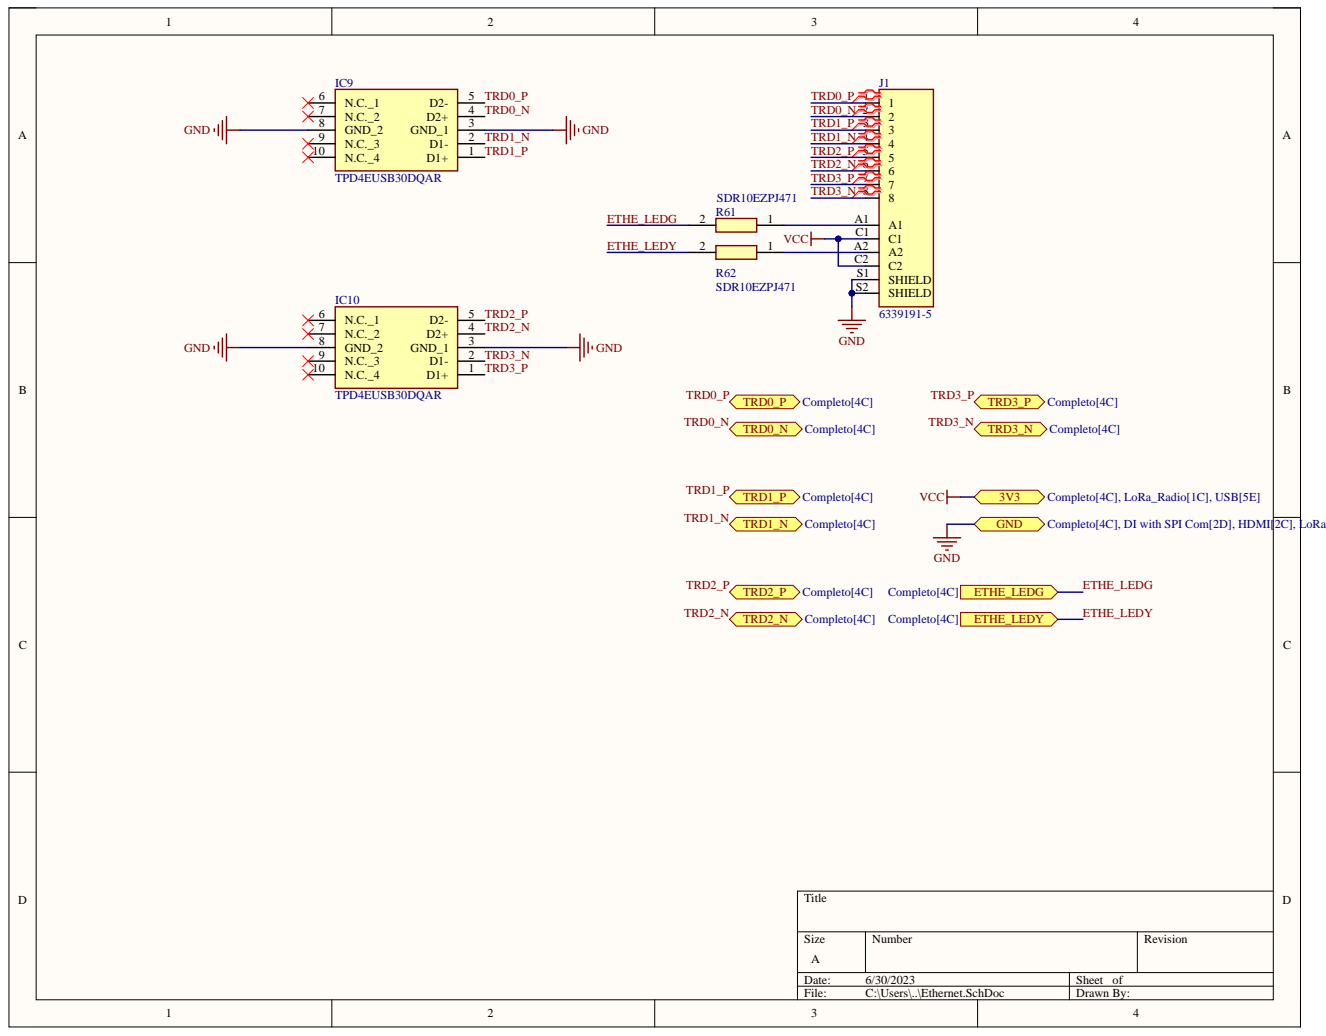
[picture p79: page 6]

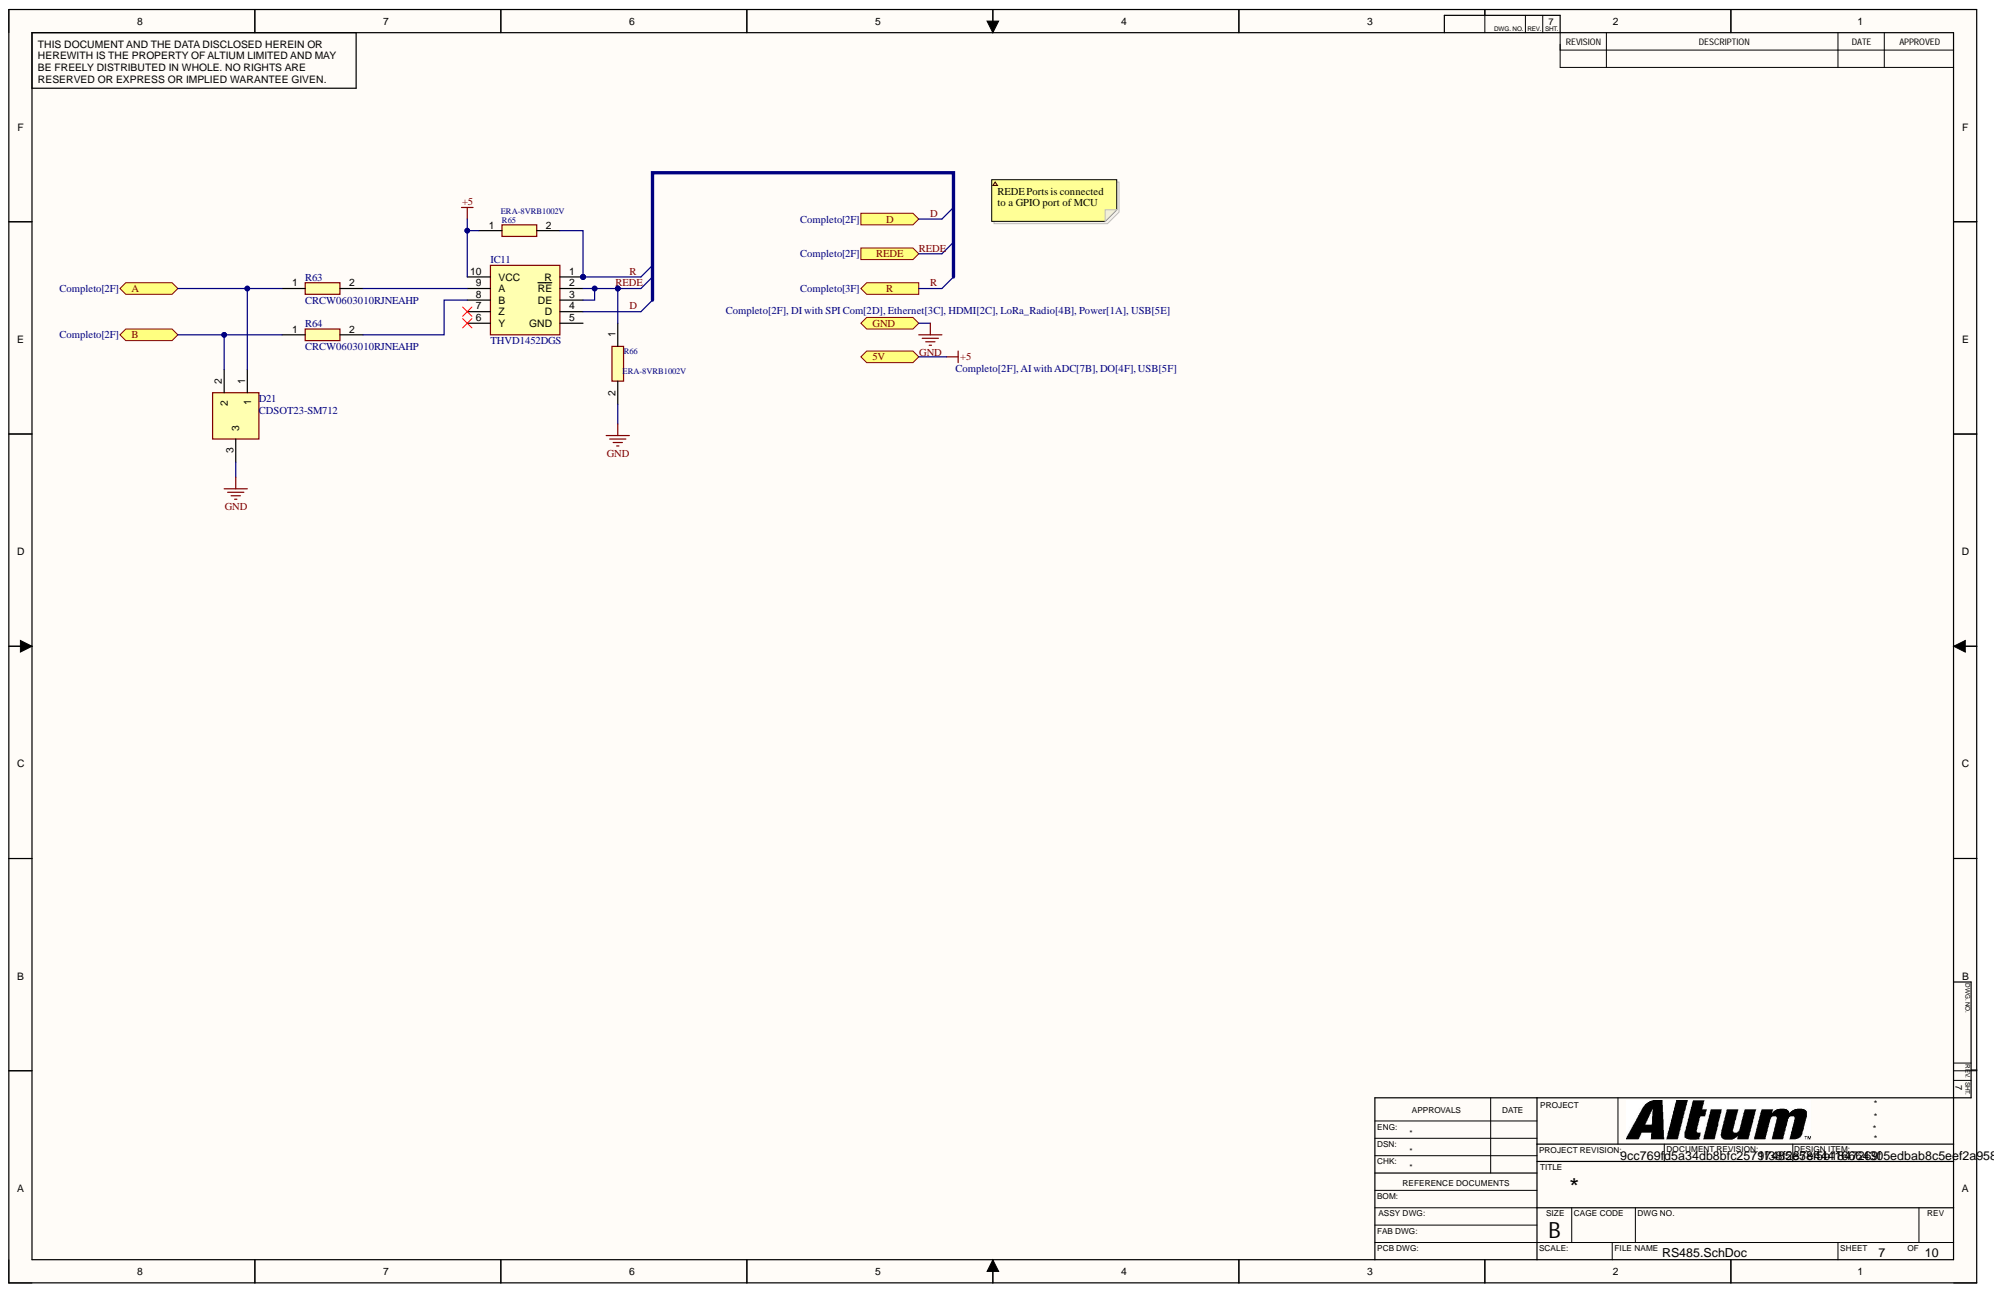
[picture p80: page 7]

DWG. NO | . REV | 7 . SHT | .

TH IS D O C UMEN T AN D THE D ATA D ISCLOSED HEREI N O R HEREWITH IS THE PR OPERTY OF ALTI UM LIMITED AN D MAY BE FREEL Y D ISTR IBUTED I N WH OLE. N O R I G HTS AR E RESERVED O R EXPRESS O R IMPLIED WARANTEE G IVEN . | | RE VISION | DE SCRIPTION | DATE | APPROVE D

REV. SHT. DWG. NO.

DATE | PROJEC T | **** APPROVALS

ENG: DSN:

PROJEC T REVISION : 9c | DOC U MEN T REVISION : | DESIGN I TEM :

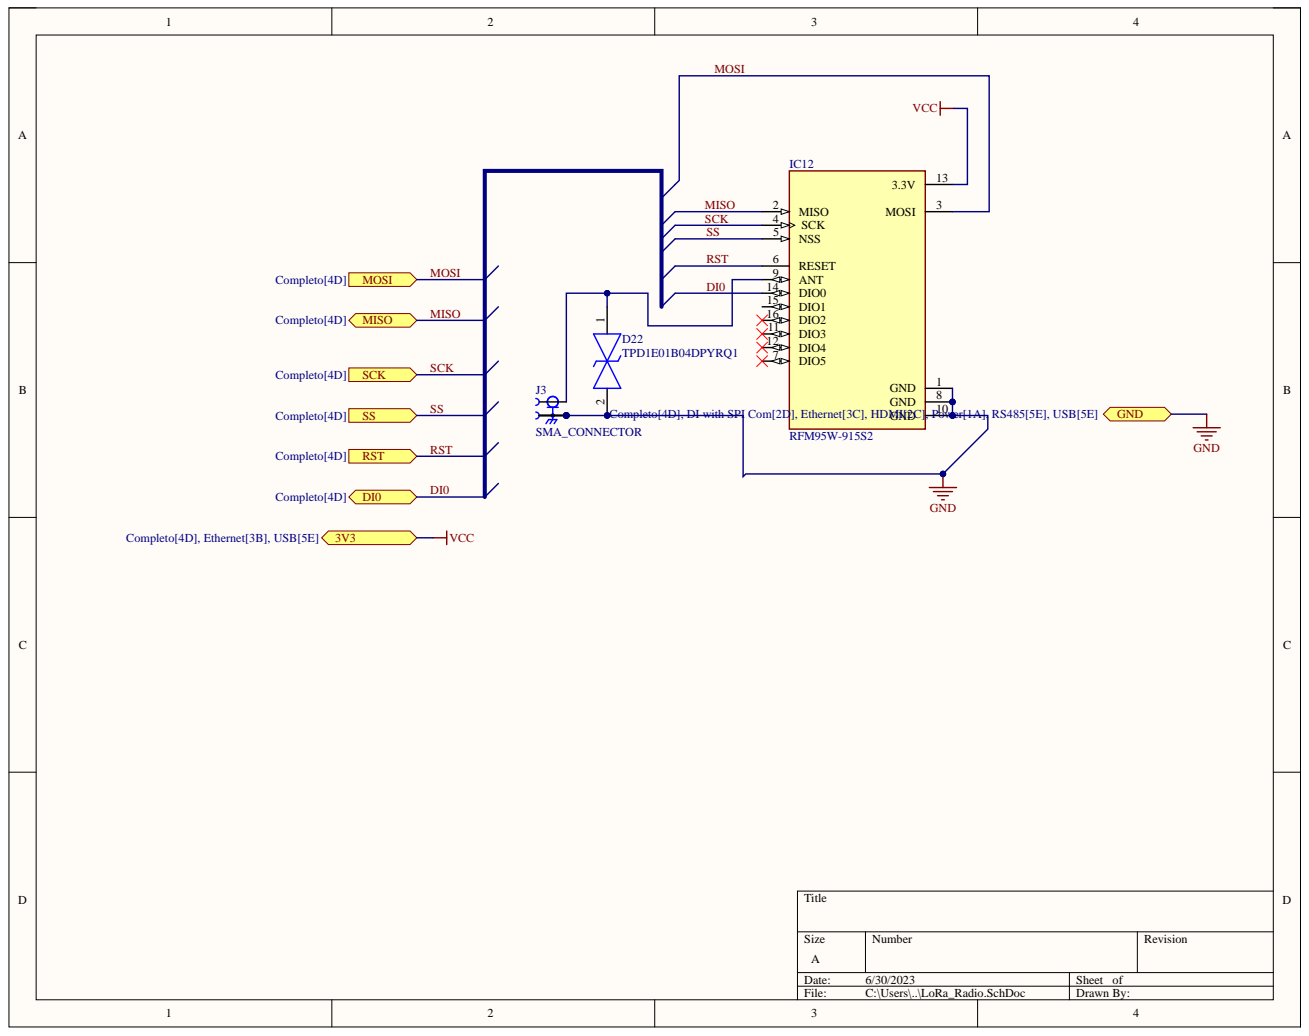
[picture p81: page 8]

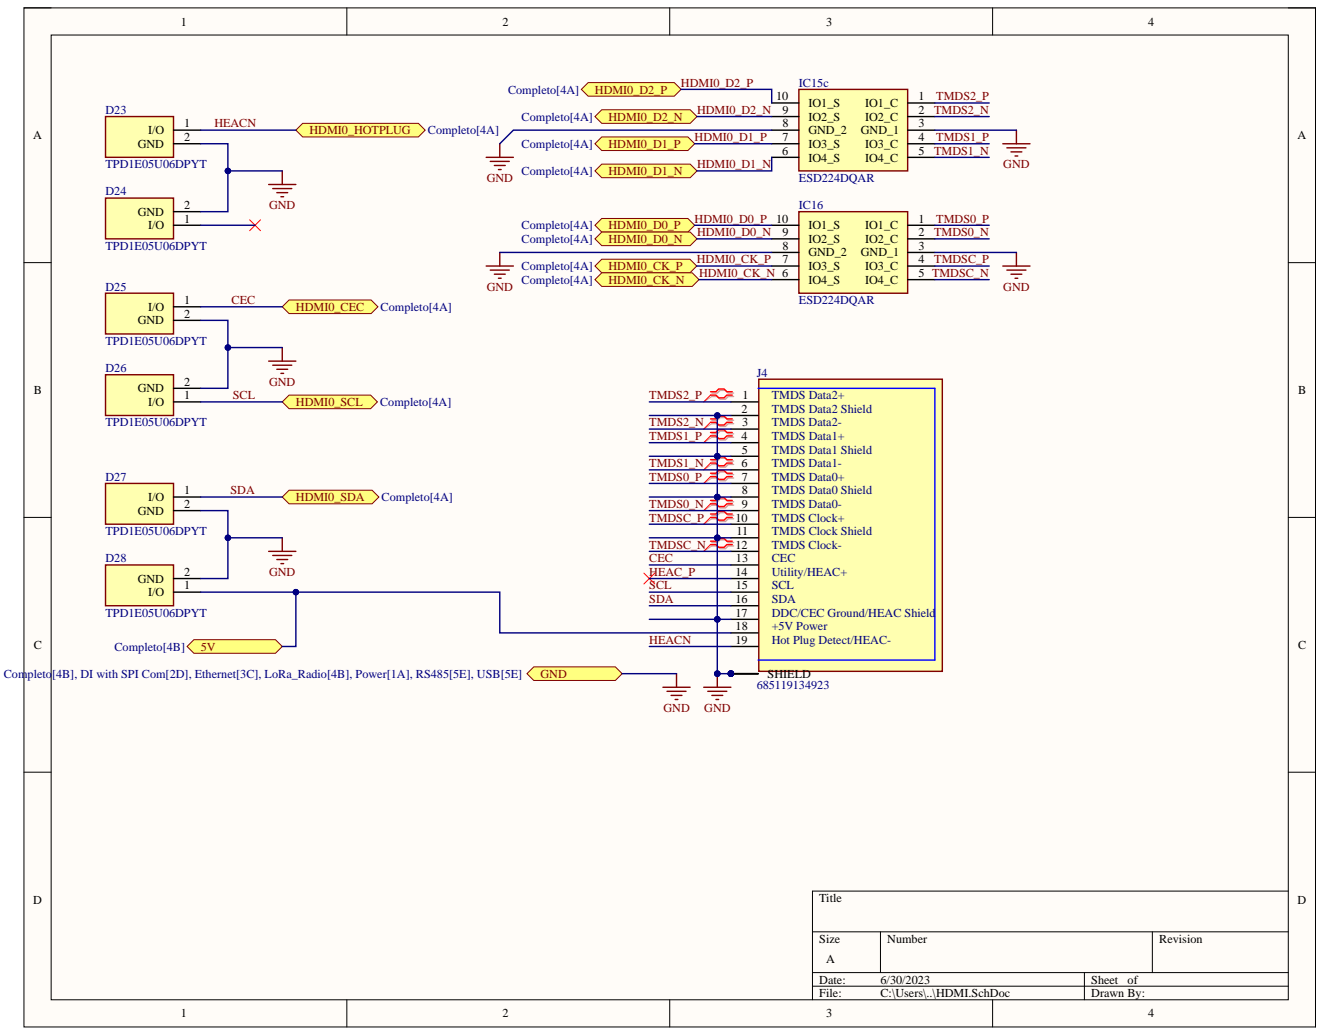
[picture p82: page 9]

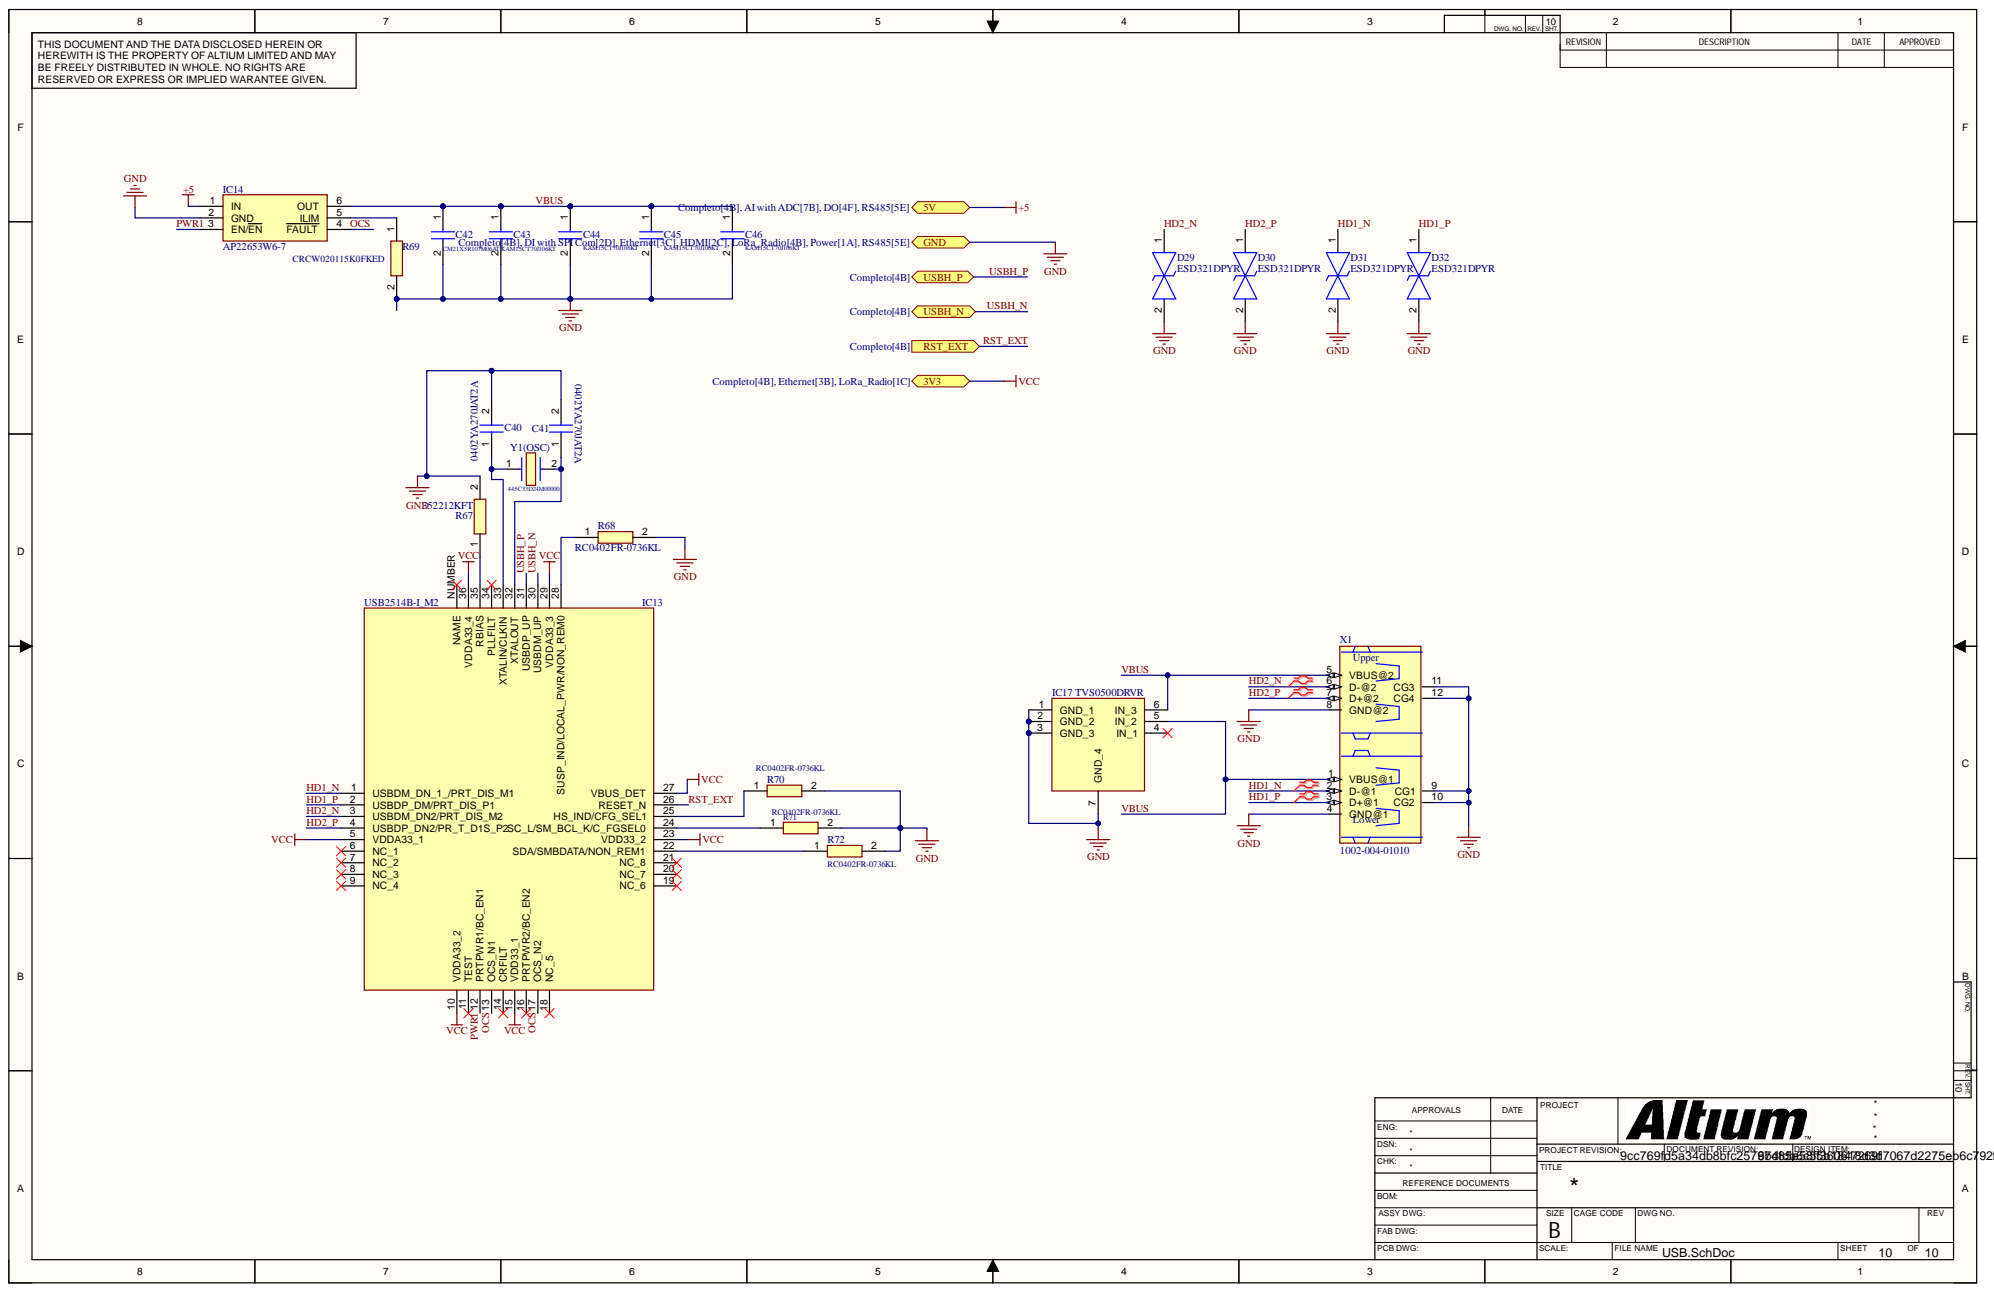
[picture p83: page 10]

8 | 7 | 6 | 5 | 4 | 3 | DWG. NO. | REV. | 10 SHT. | 2 | 1

THIS DOCUMENT AND THE DATA DISCLOSED HEREIN OR HEREWITH IS THE PROPERTY OF ALTIUM LIMITED AND MAY BE FREELY DISTRIBUTED IN WHOLE. NO RIGHTS ARE RESERVED OR EXPRESS OR IMPLIED WARANTEE GIVEN. | | REVISION | DESCRIPTION | DATE | APPROVED

REV. SHT. DWG. NO.

DATE | PROJECT | * * APPROVALS * *

ENG: *

DSN: *

PROJECT REVISION: | DOCUMENT REVISION: | DESIGN ITEM:

CHK: *

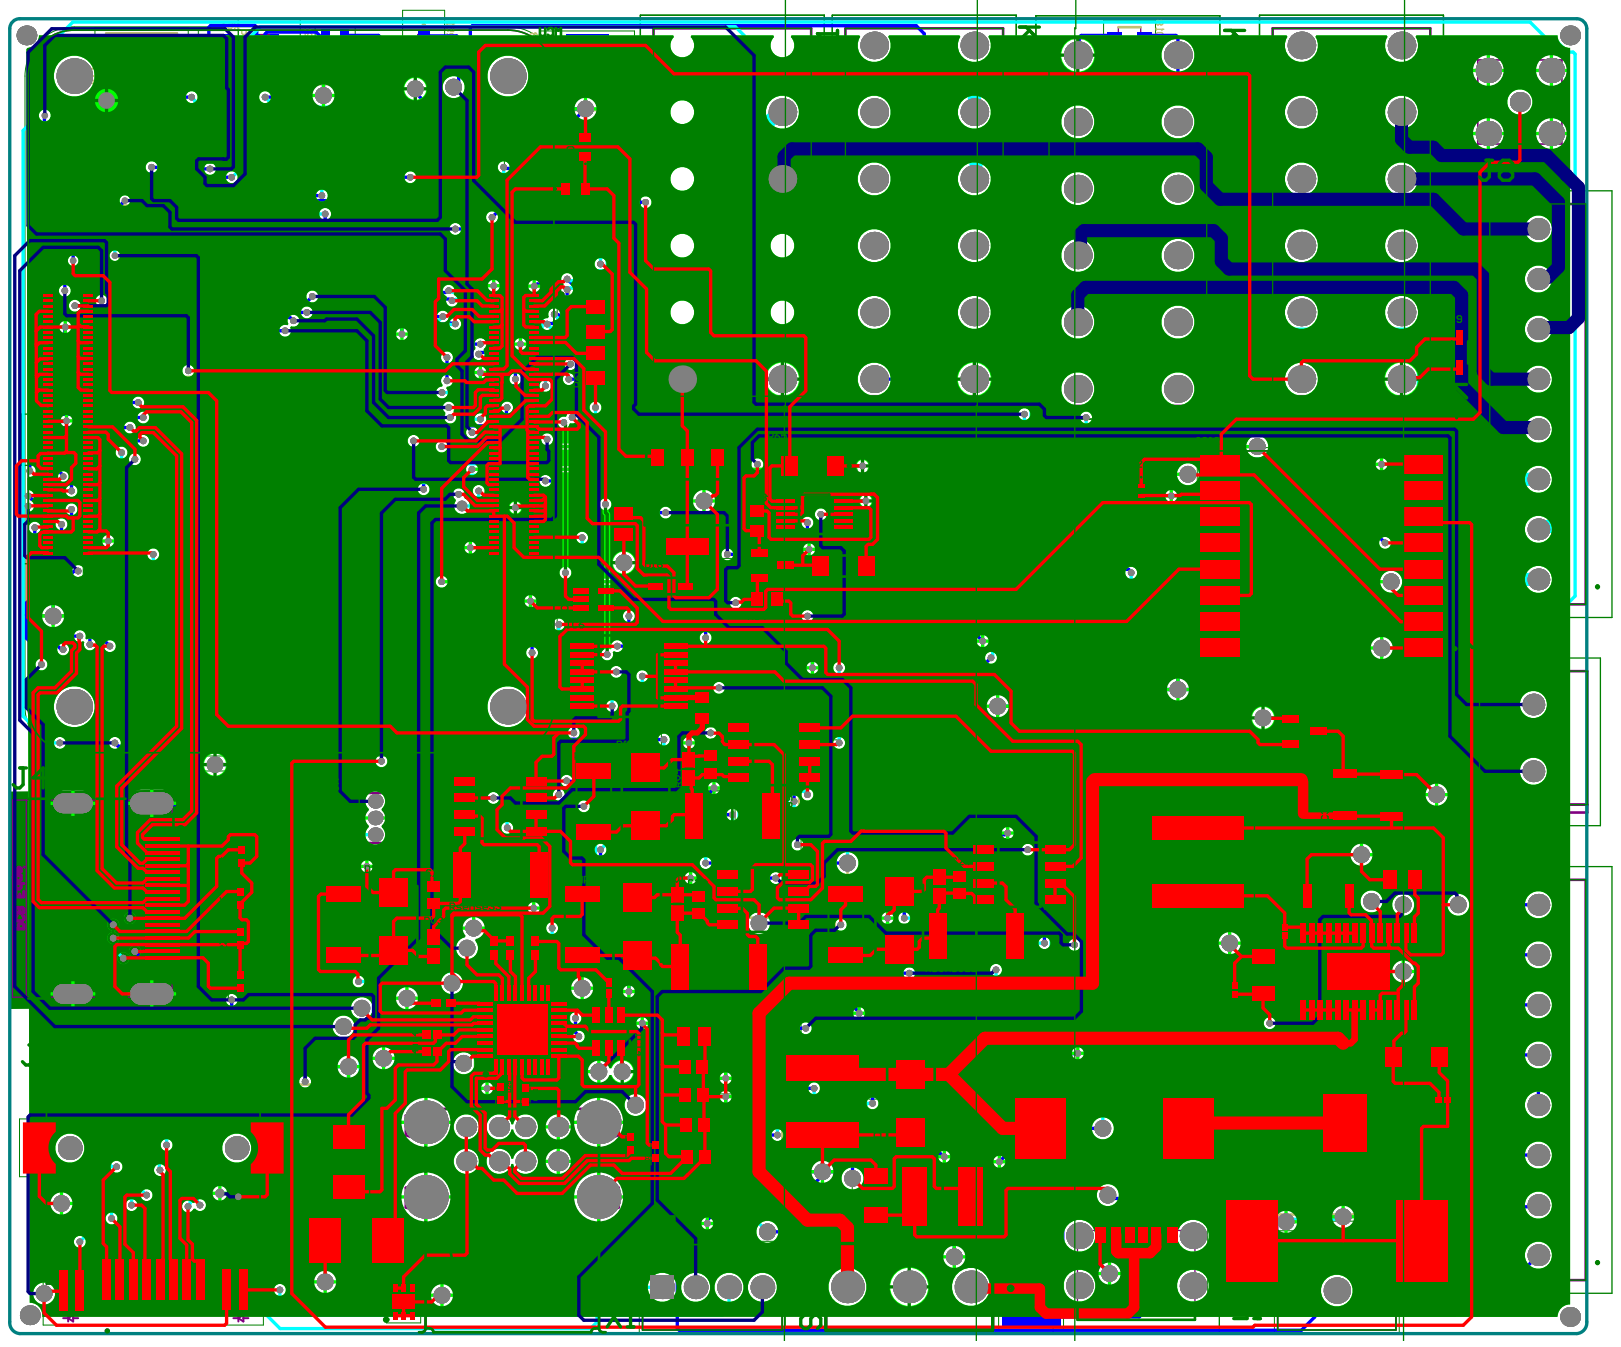
[picture p84: page 11]
