Vlasevi/rtuindustrial/Analog Inputs/tvs_test1.asc

C1: cap; 1n
C2: cap; 8.2µ
D1: zener; bzx84c5v1l
I1: current; PWL file=I45.txt
R_PTC: res; 2.3
R_PWR: res; 50
R_sense: res; 250
Rs: res; 243
U1: tvs_bipolar_diode; SMBJ10CA
Named nets: V1, V2, 0, ADC, Vin
.lib SPICE_SMBJxxxxCA.lib
.tran 500u
.lib bzx84c5v1l.lib
