Vlasevi/rtuindustrial/Digital Input/tvs_test1.asc

C1: cap; 10n
D1: TVSdiode; SMBJ26CA
R1: res; 562
R_PWR: res; 2.49k
U2: ISO1211_TRANS
V1: voltage; 60
V2: voltage; 3.3
V4: voltage; 1
Named nets: V1, V2, 0, Vin, 3V3
.lib SPICE_SMBJxxxxCA.lib
.tran 1s
.lib bzx84c5v1l.lib
.lib ISO1211_TRANS.lib
