Vlasevi/rtuindustrial/Digital Output/DO.asc

D1: schottky; RB522FS-30
L2: ind; 65mH
Q1: npn; 2N3904
R1: res; 3.6k
R2: res; 1000
R3: res; 11k
R4: res; 130
S1: sw; RELAYSW
V1: voltage; 5
V2: voltage; PULSE(3.3 0 0 1n 1n 4 8)
V3: voltage; 1000
Named nets: 0, Vb, V_mcu, V+, V-
.tran 60s
.model RELAYSW SW(Ron=50m Roff=100G Vt=3.5 Vh=0.5)
