Vlasevi/rtuindustrial/Power/Power_2.asc

C1: cap; 10n
C2: cap; 10n
C3: cap; 2.2µ
C4: cap; 22µ
C5: cap; 0.1µ
C6: cap; 47µ
C7: cap; 47µ
L1: ind; 6.8µ
R1: res; 10k
R2: res; 200k
R3: res; 100k
R4: res; 3.3
R5: res; {R}
U1: LTC3649
U2: tvs_bipolar_diode; SMBJ36CA
V1: voltage; 36
Named nets: 0, Vpower, Output, Vreg
.tran 0 10m 0
.lib SPICE_SMBJxxxxCA.lib
.step param R list 1 5 10 20
