Vlasevi/rtuindustrial/Standards (Orcad and LTspice)/IEC 61000-4-2 (ESD)/IEC61000_4_2.asc

C1: cap; 150p
C2: cap; 8p
L1: ind; 2.4µ
L2: ind; 140n
R1: res; 330
R2: res; 200
R3: res; 1
S1: sw; MYSW
S2: sw; MYSW
V1: voltage; PULSE(0 1 {td} 1f 1 1 2)
Named nets: 0, c1, c2
.model MYSW SW(Ron=0.1 Roff=1G Vt=0.5)
.ic V(c1)=nom_voltage V(c2)=nom_voltage
.param nom_voltage= IEC61000_4_2_test_level*2000
.param IEC61000_4_2_test_level=4
.param td=1p
.tran 150n
