Vlasevi/rtuindustrial/Standards (Orcad and LTspice)/IEC 61000-4-5 (Surge)/45.asc

C1: cap; 6.04µ
L1: ind; 10.4µ
R1: res; 1k
R2: res; 940m
R3: res; 19.8
R4: res; 25.1
SW: sw; MYSW
V1: voltage; 4.3k
V2: voltage; PULSE(0 5 10u 1n 1n 500u 10u 1)
Named nets: 0, Vout
.model MYSW SW(Ron=0.00000001 Roff=10000Meg Vt=3.5 Vh=-.4)
.tran 400u
