Vlasevi/rtuindustrial/Standards (Orcad and LTspice)/Simulaciones (ondas en txt)/Estandares.asc

I1: current; PWL file=I42.txt
I2: current; PWL file=I45.txt
R1: res; 1
R2: res; 1
R3: res; 1
R4: res; 1
V1: voltage; PWL file=V44.txt
V2: voltage; PWL file=V45.txt
Named nets: 0
.tran 100u
