Vlasevi/rtuindustrial/Standards (Orcad and LTspice)/IEC 61000-4-4 (EFT)/LTspice/Draft1.asc

C1: cap; 6µ
C2: cap; 1µ
R1: res; 12m
R2: res; 50
R4: res; 50k
S1: sw; MYSW
S2: sw; MYSW
S3: sw; MYSW
V1: voltage; 4000
V2: voltage; PULSE(0 1 0 1n 1n 5u 200u)
V3: voltage; PULSE(0 1 100u 1n 1n 5u 200u)
V4: voltage; PULSE(0 1 0 1n 1n 15m 315m 1)
Named nets: Vsc, Vsd, 0, Vtd, Vout
.tran 16m
.model MYSW SW(Ron=0.000001 Roff=1000000000Meg Vt=.5 Vh=-.4)
