Vlasevi/rtuindustrial/(list of files, drawings)

Other design files:
Digital Input/ISO1211_TRANS.OPJ
Digital Input/ISO1211D_TRANS.OLB
Standards (Orcad and LTspice)/IEC 61000-4-4 (EFT)/IEC 61000-4-4.DSN
Standards (Orcad and LTspice)/IEC 61000-4-4 (EFT)/iec 61000-4-4.opj
Standards (Orcad and LTspice)/IEC 61000-4-5 (Surge)/IEC 61000-4-5.dsn
Standards (Orcad and LTspice)/IEC 61000-4-5 (Surge)/IEC 61000-4-5.opj
