Vlasevi/rtuindustrial/(commit log)

2023-07-09 Add files via upload
    Lista de materiales diseño PCB
    [BOM_f.xlsx]
2023-07-09 Subiendo las imagenes de la PCB
2023-07-09 Borrado algunos archivos
    [BOM_f.xlsx]
2023-07-09 Nuevos archivos
    [ADS1x4S0x Design Calculator.xlsx, Bill of Materials.xlsx, IEC 61000-4-4.DSN, IEC 61000-4-5.dsn, IEC 61000-4-5.opj, ISO1211D_TRANS.OLB, ISO1211_TRANS.OPJ, iec 61000-4-4.opj]
